thinkl33t/Mendel90/bobhuxley/sheets/y_heatshield.dxf

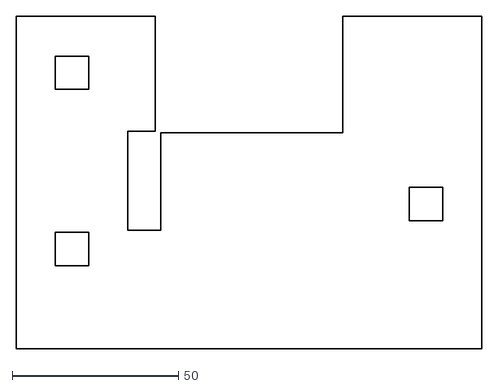
[picture p1: CAD file, 2016-01-12]
bobhuxley/sheets/y_heatshield.dxf
140.0 x 100.0
