thinkl33t/Mendel90/bobhuxley/stls/printed/dust_filter.stl

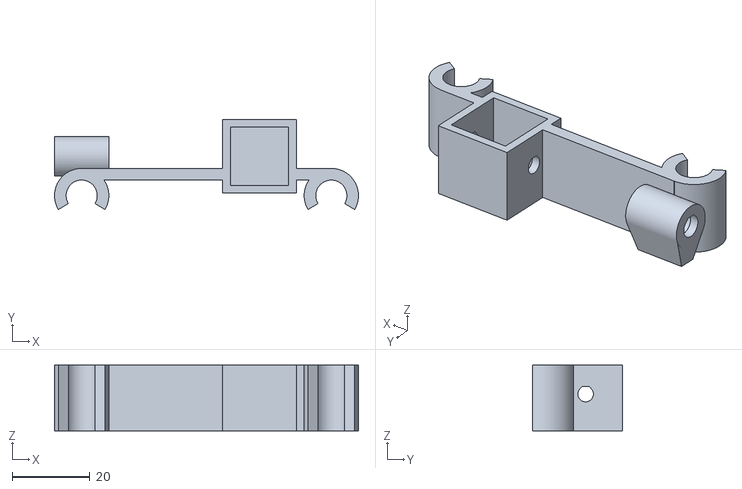
[picture p2: CAD file, 2016-01-12]
bobhuxley/stls/printed/dust_filter.stl
78.3 x 23.2 x 17.0
