thinkl33t/Mendel90/bobhuxley/stls/rpi_camera_back.stl

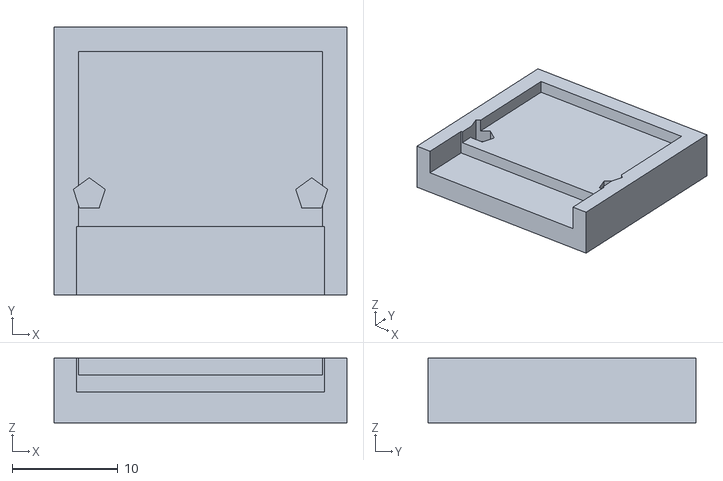
[picture p3: CAD file, 2016-01-12]
bobhuxley/stls/rpi_camera_back.stl
27.7 x 25.3 x 6.10
