thinkl33t/Mendel90/bobhuxley/sheets/frame_left.dxf

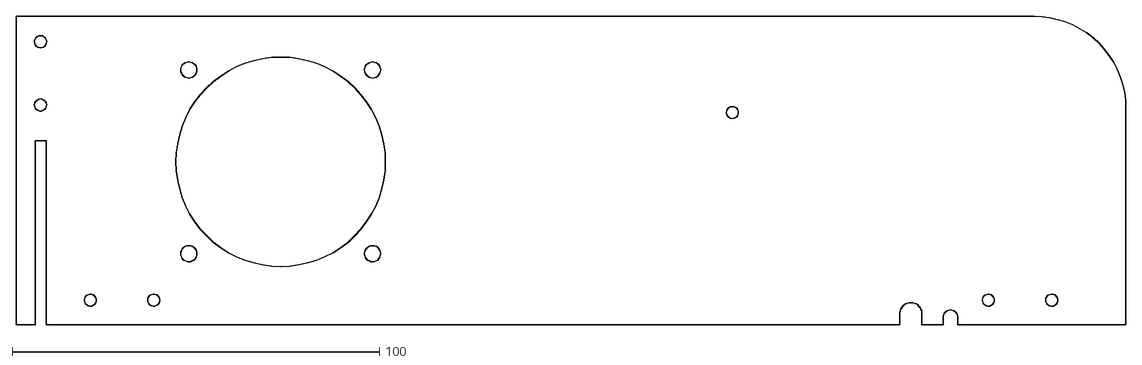
[picture p4: CAD file, 2016-01-12]
bobhuxley/sheets/frame_left.dxf
302.0 x 83.9
