thinkl33t/Mendel90/bobhuxley/stls/printed/tube_cap.stl

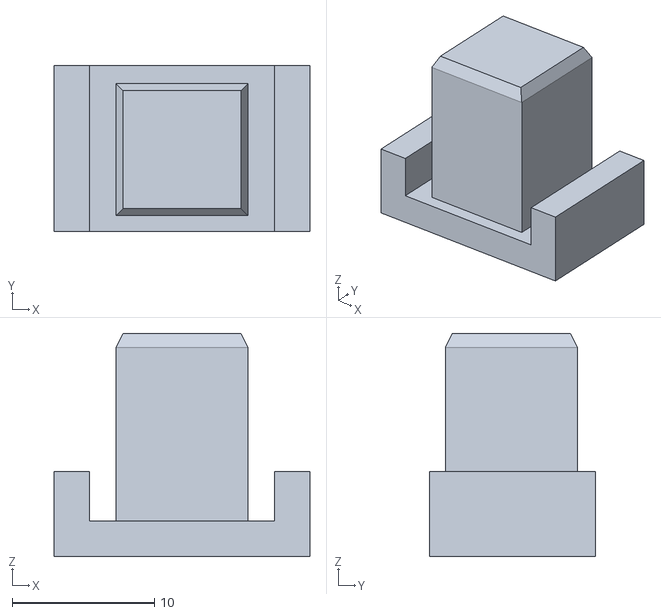
[picture p5: CAD file, 2016-01-12]
bobhuxley/stls/printed/tube_cap.stl
18.0 x 11.7 x 15.7
