thinkl33t/Mendel90/bobhuxley/sheets/frame_gantry_and_y_carriage.dxf

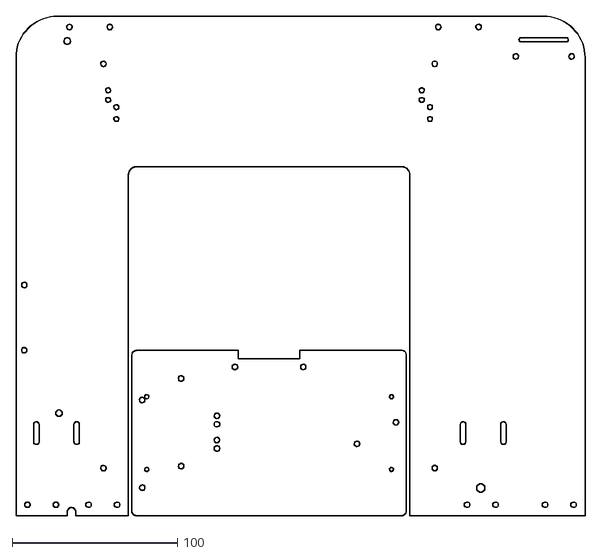
[picture p6: CAD file, 2016-01-12]
bobhuxley/sheets/frame_gantry_and_y_carriage.dxf
344.0 x 302.0
