thinkl33t/Mendel90/bobhuxley/stls/printed/wades_extruder.stl

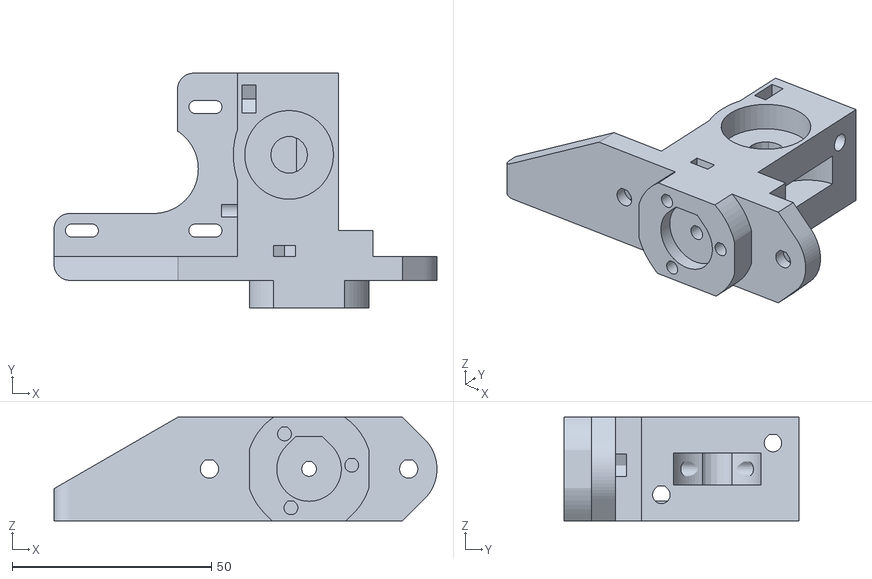
[picture p7: CAD file, 2016-01-12]
bobhuxley/stls/printed/wades_extruder.stl
96.1 x 58.9 x 26.0
