thinkl33t/Mendel90/bobhuxley/stls/y_bar_clamp.stl

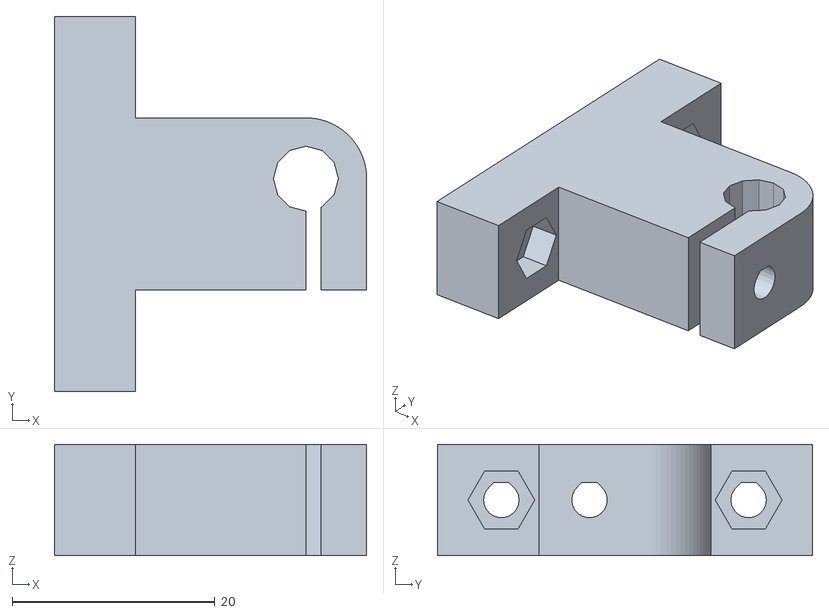
[picture p8: CAD file, 2016-01-12]
bobhuxley/stls/y_bar_clamp.stl
30.8 x 37.0 x 11.0
