thinkl33t/Mendel90/bobhuxley/sheets/frame_base.dxf

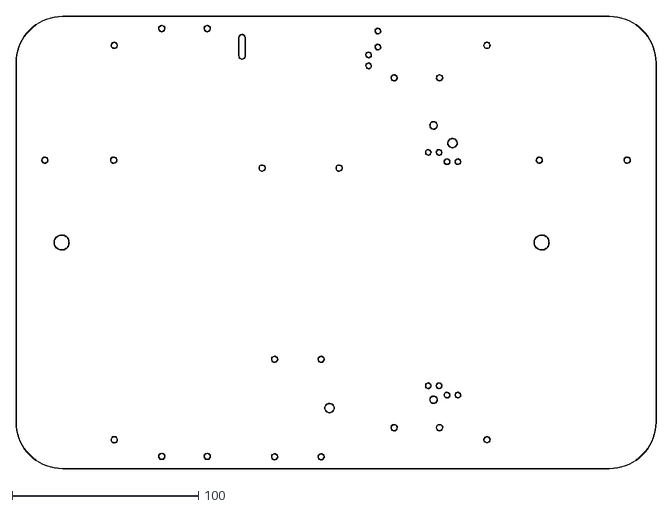
[picture p9: CAD file, 2016-01-12]
bobhuxley/sheets/frame_base.dxf
344.0 x 243.0
