thinkl33t/Mendel90/bobhuxley/stls/printed/y_idler_bracket.stl

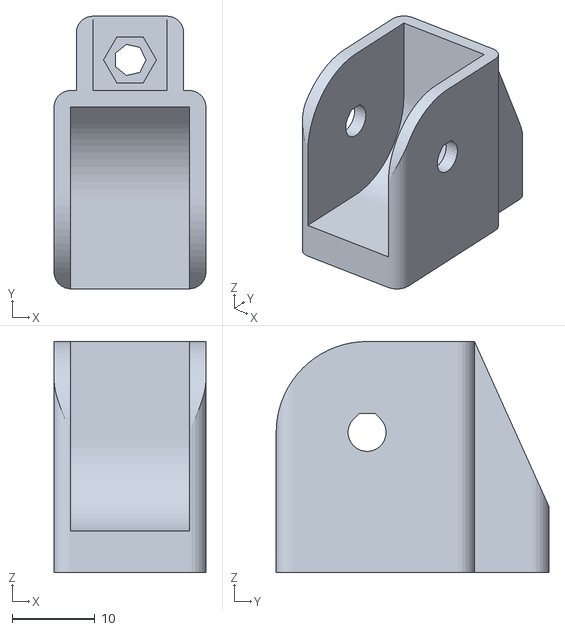
[picture p10: CAD file, 2016-01-12]
bobhuxley/stls/printed/y_idler_bracket.stl
18.4 x 33.0 x 27.9
