thinkl33t/Mendel90/bobhuxley/stls/ribbon_clamp_26_33N.stl

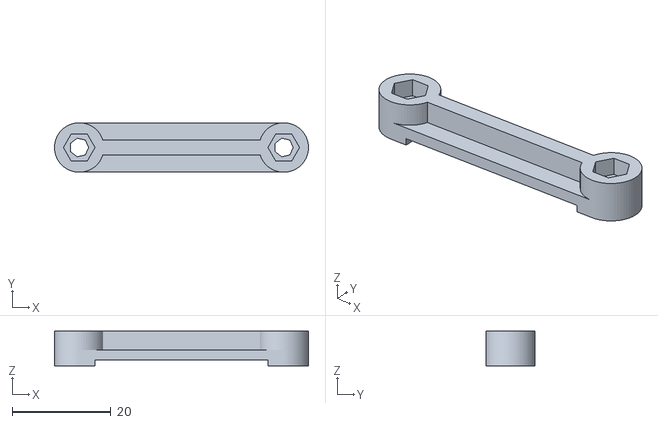
[picture p11: CAD file, 2016-01-12]
bobhuxley/stls/ribbon_clamp_26_33N.stl
51.3 x 10.00 x 7.00
