thinkl33t/Mendel90/bobhuxley/sheets/frame_stays.dxf

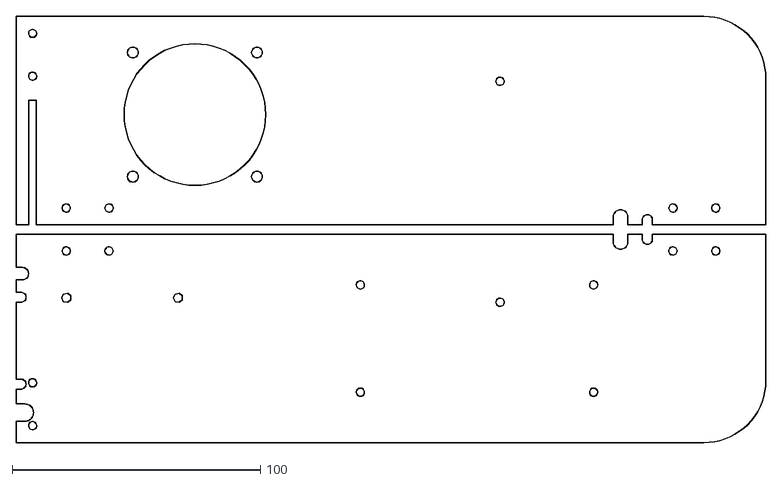
[picture p12: CAD file, 2016-01-12]
bobhuxley/sheets/frame_stays.dxf
302.0 x 171.8
