thinkl33t/Mendel90/bobhuxley/stls/ribbon_clamp_14_33NB.stl

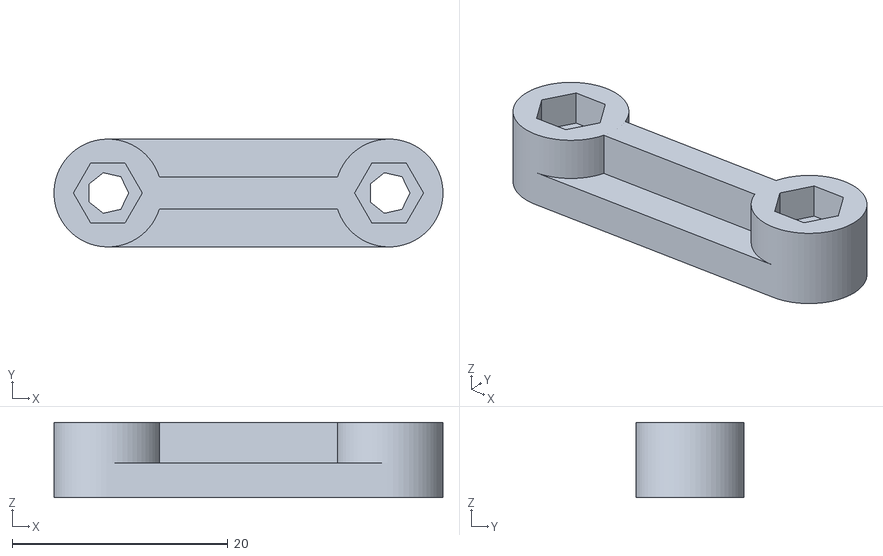
[picture p13: CAD file, 2016-01-12]
bobhuxley/stls/ribbon_clamp_14_33NB.stl
36.1 x 10.00 x 7.00
