thinkl33t/Mendel90/bobhuxley/sheets/frame_right.dxf

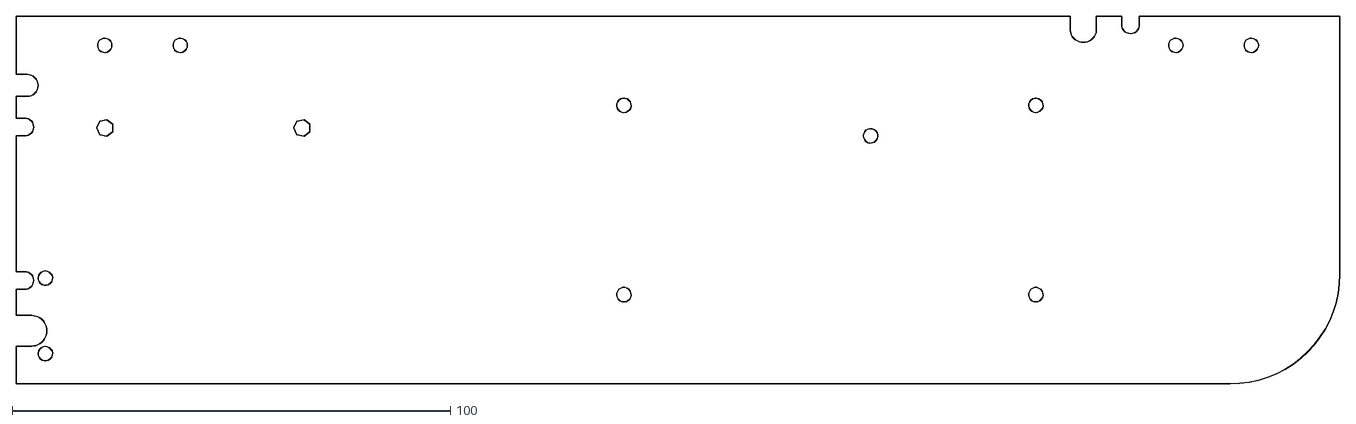
[picture p14: CAD file, 2016-01-12]
bobhuxley/sheets/frame_right.dxf
302.0 x 83.9
