thinkl33t/Mendel90/bobhuxley/stls/printed/spool_holder_brackets.stl

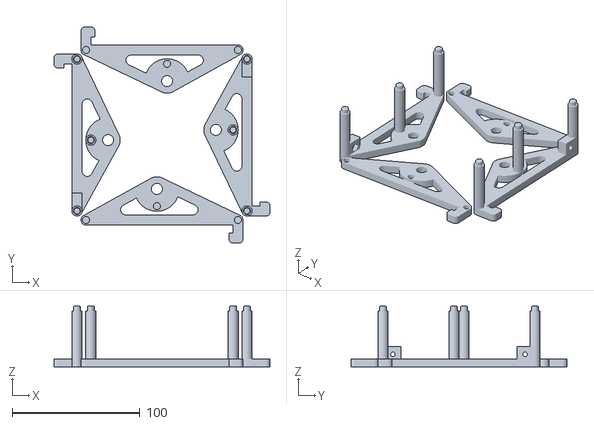
[picture p15: CAD file, 2016-01-12]
bobhuxley/stls/printed/spool_holder_brackets.stl
168.9 x 168.9 x 47.4
