thinkl33t/Mendel90/bobhuxley/stls/y_belt_anchor_toothed.stl

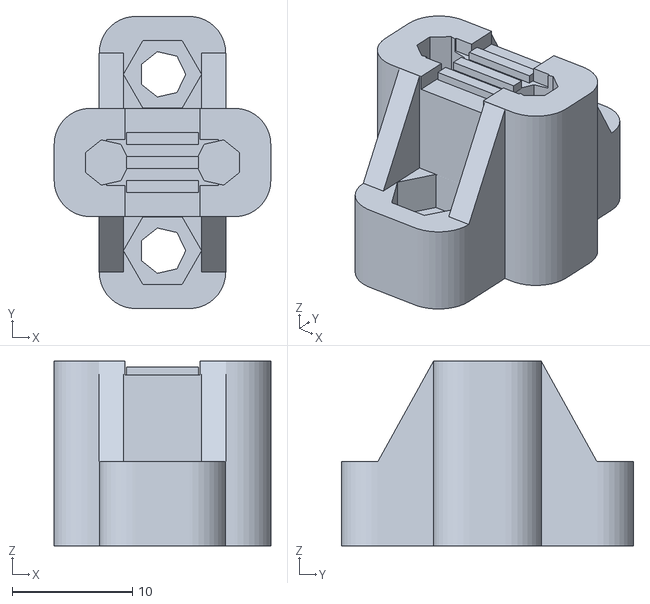
[picture p16: CAD file, 2016-01-12]
bobhuxley/stls/y_belt_anchor_toothed.stl
18.0 x 24.3 x 15.3
