thinkl33t/Mendel90/bobhuxley/sheets/frame_gantry.dxf

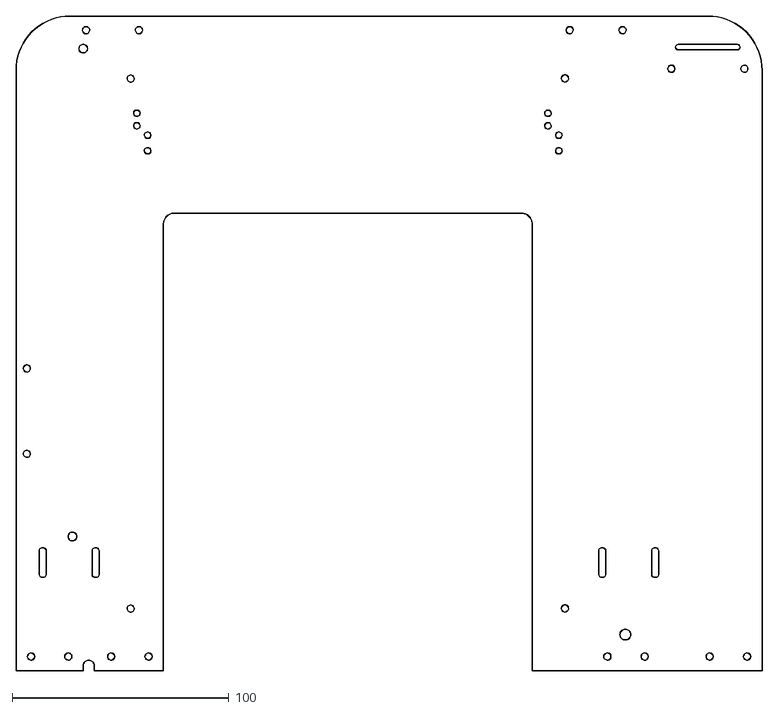
[picture p17: CAD file, 2016-01-12]
bobhuxley/sheets/frame_gantry.dxf
344.0 x 302.0
