thinkl33t/Mendel90/bobhuxley/stls/printed/fixing_blocks.stl

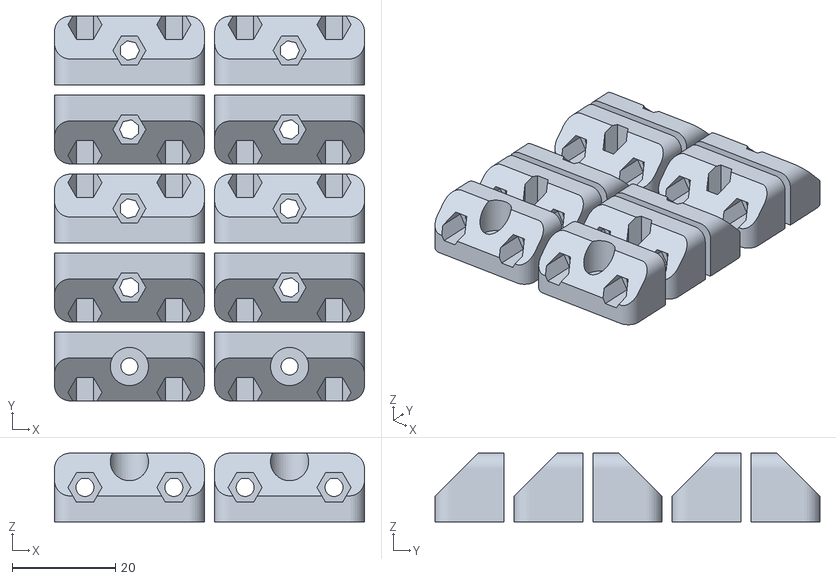
[picture p18: CAD file, 2016-01-12]
bobhuxley/stls/printed/fixing_blocks.stl
60.0 x 74.5 x 13.3
