thinkl33t/Mendel90/bobhuxley/stls/x_belt_tensioner.stl

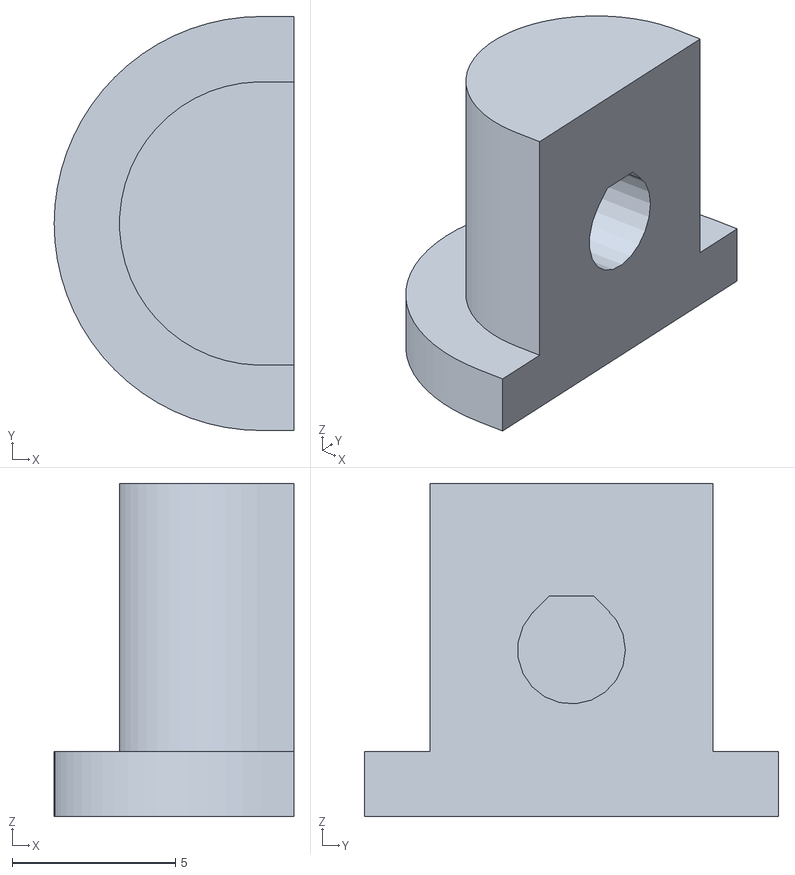
[picture p19: CAD file, 2016-01-12]
bobhuxley/stls/x_belt_tensioner.stl
7.33 x 12.7 x 10.2
