thinkl33t/Mendel90/bobhuxley/sheets/y_carriage.dxf

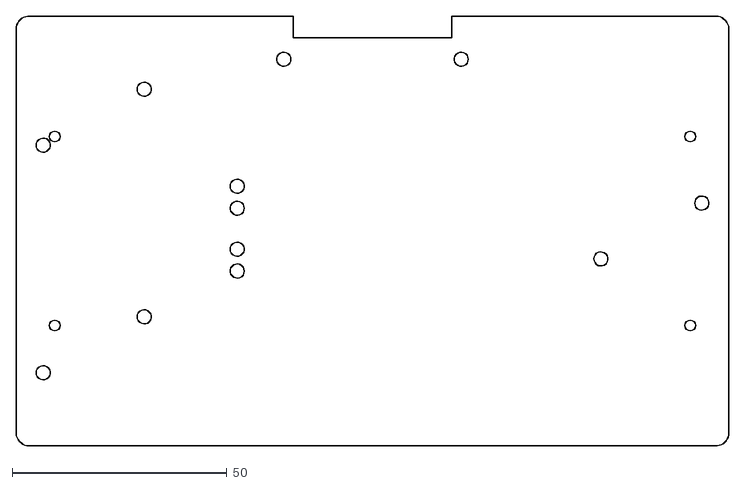
[picture p20: CAD file, 2016-01-12]
bobhuxley/sheets/y_carriage.dxf
166.0 x 100.0
