thinkl33t/Mendel90/bobhuxley/stls/printed/cable_clips.stl

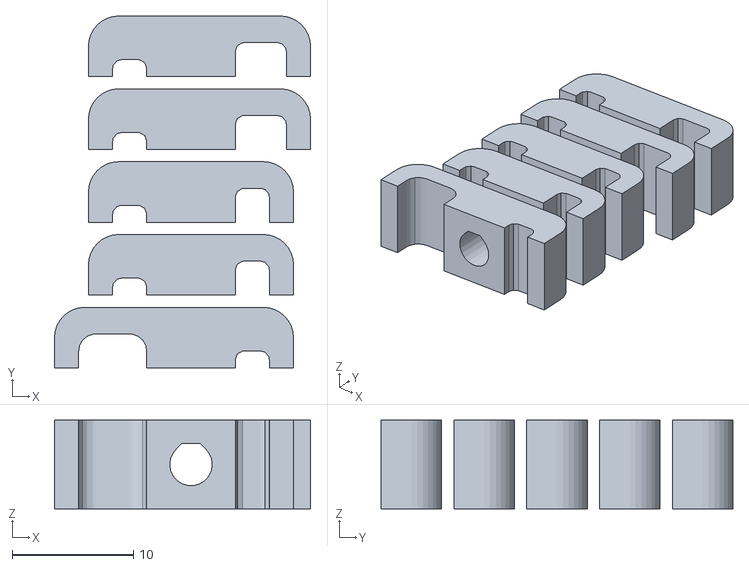
[picture p21: CAD file, 2016-01-12]
bobhuxley/stls/printed/cable_clips.stl
21.1 x 29.0 x 7.30
