thinkl33t/Mendel90/bobhuxley/stls/z_bar_clamp.stl

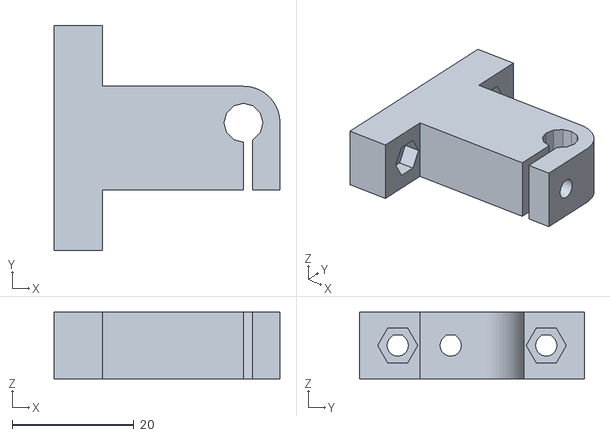
[picture p22: CAD file, 2016-01-12]
bobhuxley/stls/z_bar_clamp.stl
37.1 x 37.0 x 11.0
