thinkl33t/Mendel90/bobhuxley/stls/printed/z_coupling.stl

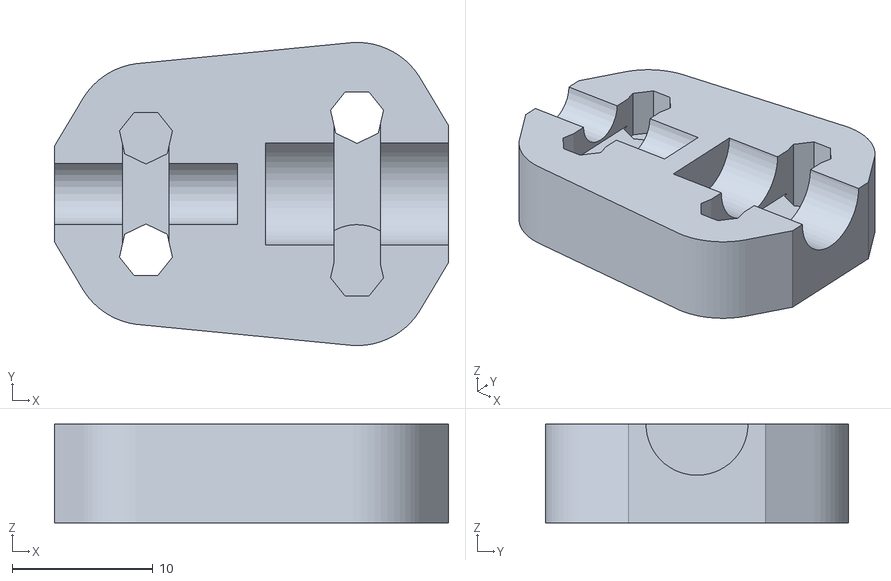
[picture p23: CAD file, 2016-01-12]
bobhuxley/stls/printed/z_coupling.stl
28.0 x 21.5 x 7.00
