thinkl33t/Mendel90/bobhuxley/stls/ribbon_clamp_14_33.stl

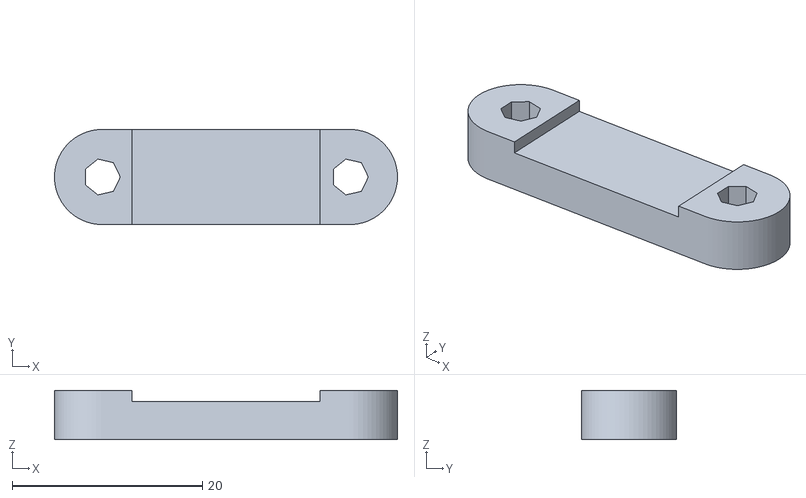
[picture p24: CAD file, 2016-01-12]
bobhuxley/stls/ribbon_clamp_14_33.stl
36.1 x 10.00 x 5.20
