thinkl33t/Mendel90/bobhuxley/stls/printed/x_idler_bracket.stl

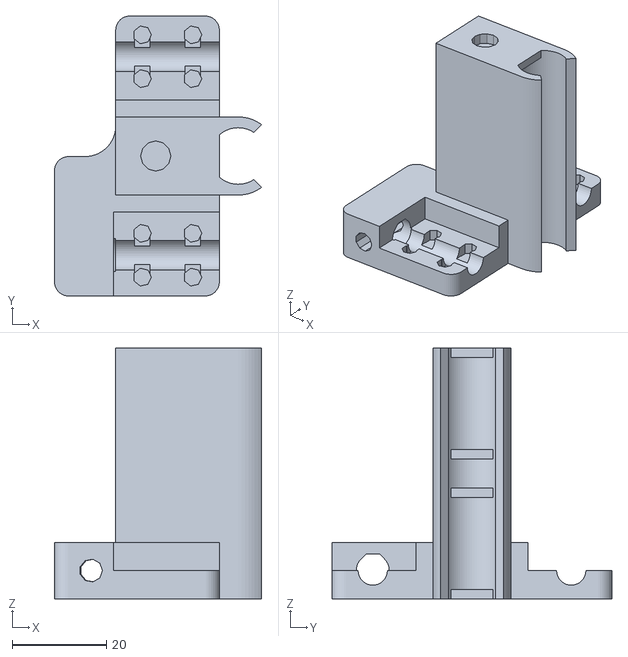
[picture p25: CAD file, 2016-01-12]
bobhuxley/stls/printed/x_idler_bracket.stl
43.9 x 59.4 x 53.2
