thinkl33t/Mendel90/bobhuxley/stls/x_carriage_fan_bracket.stl

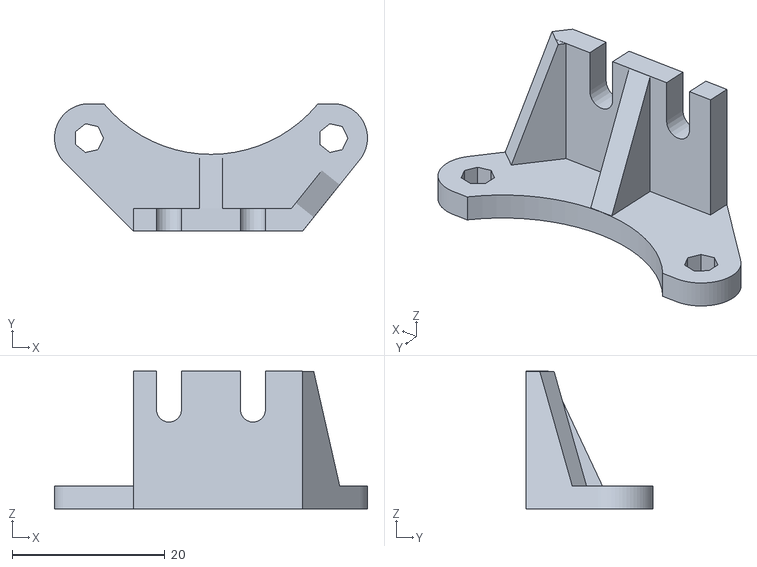
[picture p26: CAD file, 2016-01-12]
bobhuxley/stls/x_carriage_fan_bracket.stl
41.0 x 16.7 x 18.0
