thinkl33t/Mendel90/bobhuxley/stls/d_motor_bracket_lid.stl

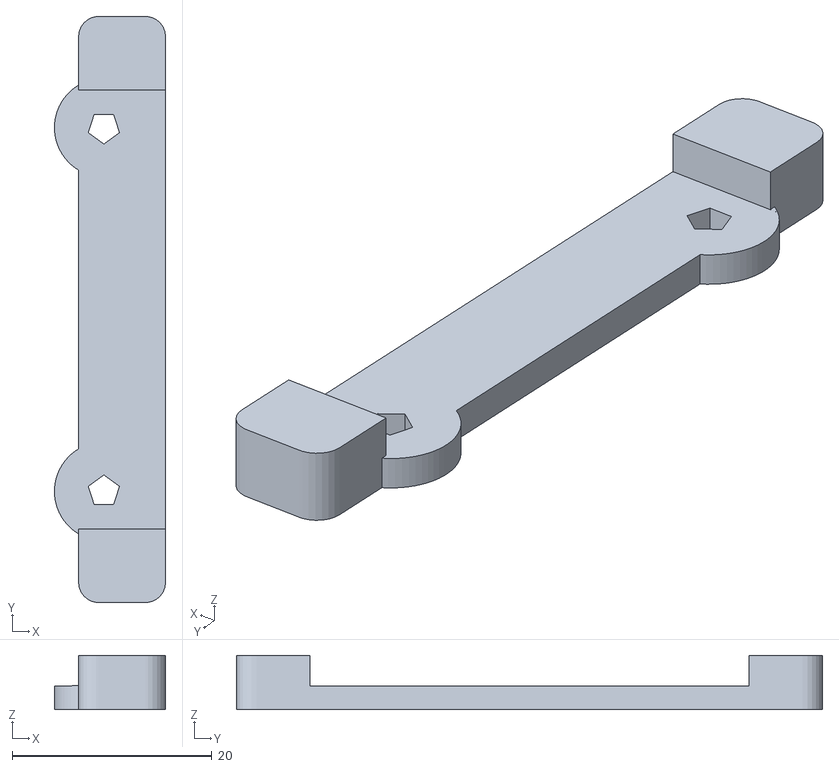
[picture p27: CAD file, 2016-01-12]
bobhuxley/stls/d_motor_bracket_lid.stl
11.1 x 58.6 x 5.45
