thinkl33t/Mendel90/bobhuxley/stls/printed/x_motor_bracket.stl

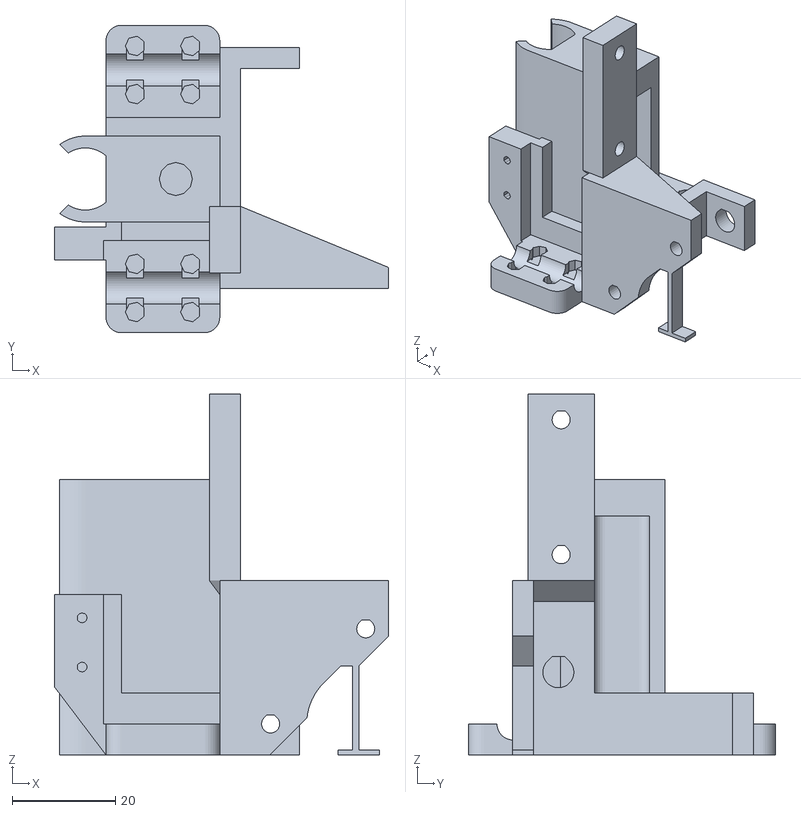
[picture p28: CAD file, 2016-01-12]
bobhuxley/stls/printed/x_motor_bracket.stl
64.6 x 59.4 x 69.8
