thinkl33t/Mendel90/bobhuxley/stls/printed/z_motor_brackets.stl

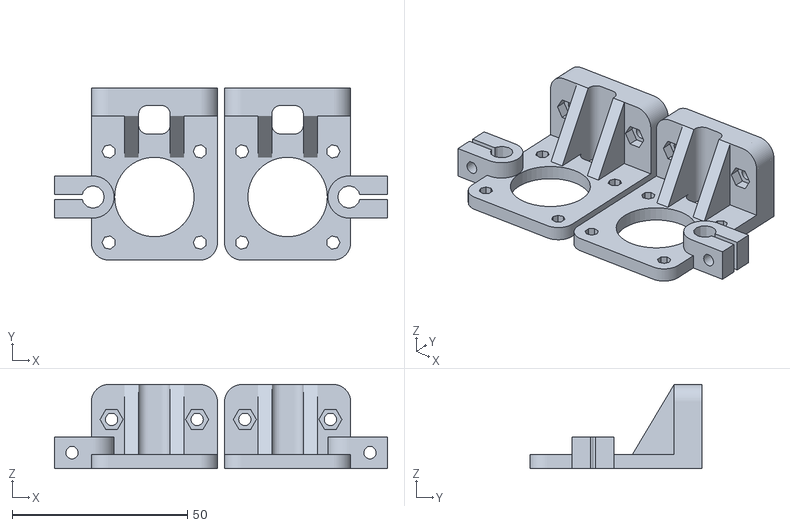
[picture p29: CAD file, 2016-01-12]
bobhuxley/stls/printed/z_motor_brackets.stl
95.0 x 49.1 x 24.0
