thinkl33t/Mendel90/bobhuxley/stls/spool_bracket_male.stl

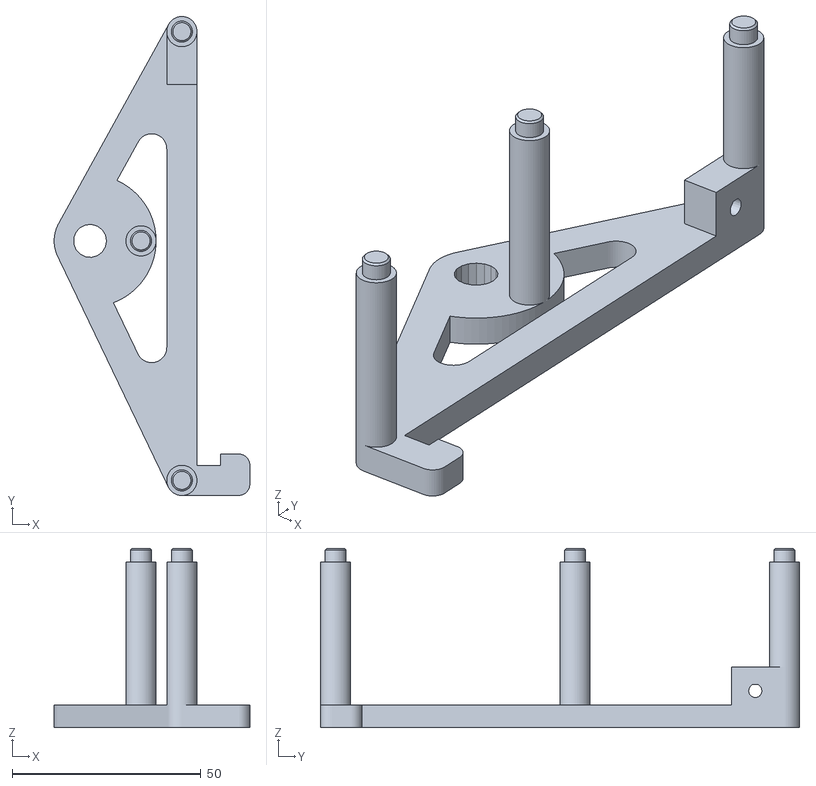
[picture p30: CAD file, 2016-01-12]
bobhuxley/stls/spool_bracket_male.stl
51.8 x 126.8 x 47.4
