thinkl33t/Mendel90/bobhuxley/stls/printed/y_motor_bracket.stl

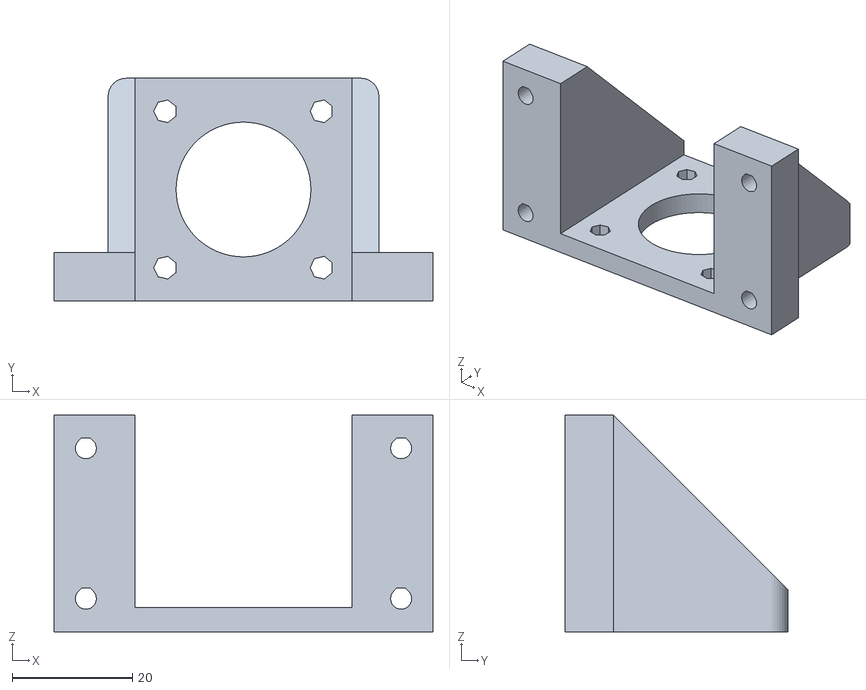
[picture p31: CAD file, 2016-01-12]
bobhuxley/stls/printed/y_motor_bracket.stl
63.0 x 37.0 x 36.0
