thinkl33t/Mendel90/bobhuxley/stls/z_motor_bracket_rhs.stl

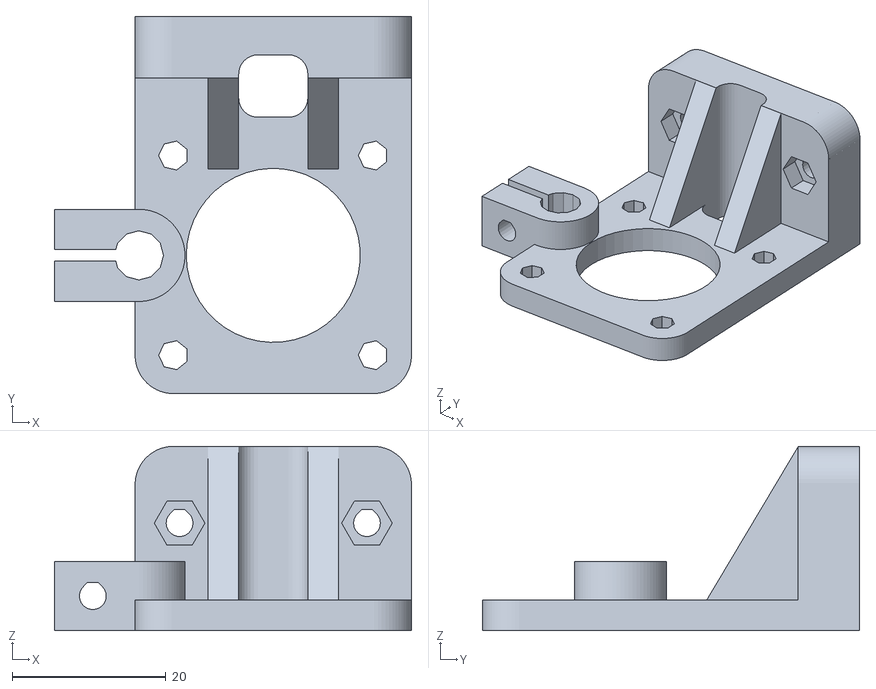
[picture p32: CAD file, 2016-01-12]
bobhuxley/stls/z_motor_bracket_rhs.stl
46.5 x 49.1 x 24.0
