thinkl33t/Mendel90/bobhuxley/stls/printed/x_end_clamp.stl

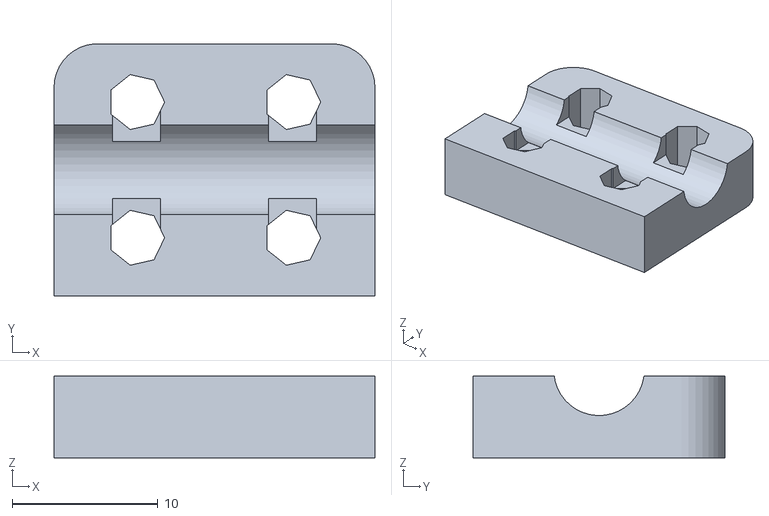
[picture p33: CAD file, 2016-01-12]
bobhuxley/stls/printed/x_end_clamp.stl
22.0 x 17.3 x 5.60
