thinkl33t/Mendel90/bobhuxley/stls/printed/atx_brackets.stl

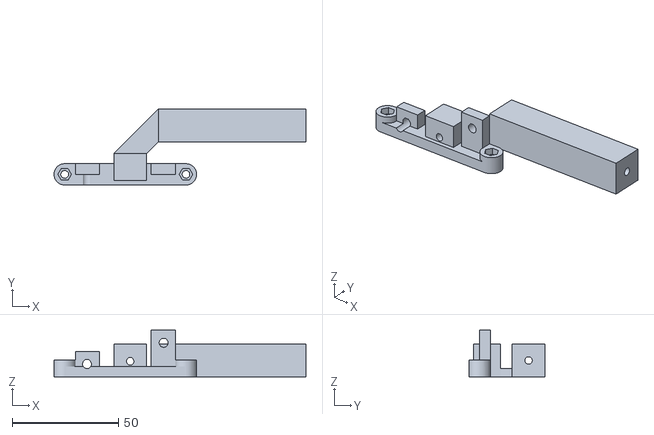
[picture p34: CAD file, 2016-01-12]
bobhuxley/stls/printed/atx_brackets.stl
118.4 x 35.7 x 22.0
