thinkl33t/Mendel90/bobhuxley/stls/x_carriage.stl

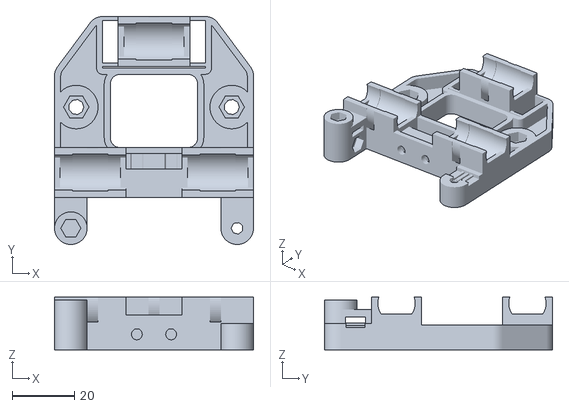
[picture p35: CAD file, 2016-01-12]
bobhuxley/stls/x_carriage.stl
64.0 x 73.3 x 17.0
