thinkl33t/Mendel90/bobhuxley/stls/printed/cal.stl

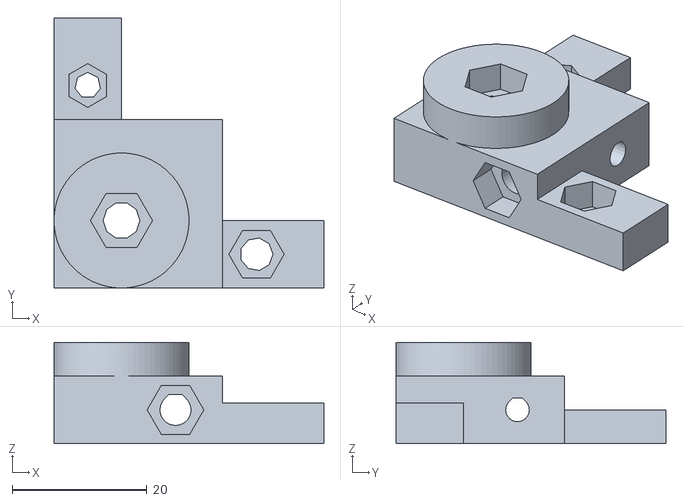
[picture p36: CAD file, 2016-01-12]
bobhuxley/stls/printed/cal.stl
40.0 x 40.0 x 15.0
