thinkl33t/Mendel90/bobhuxley/stls/direct_block.stl

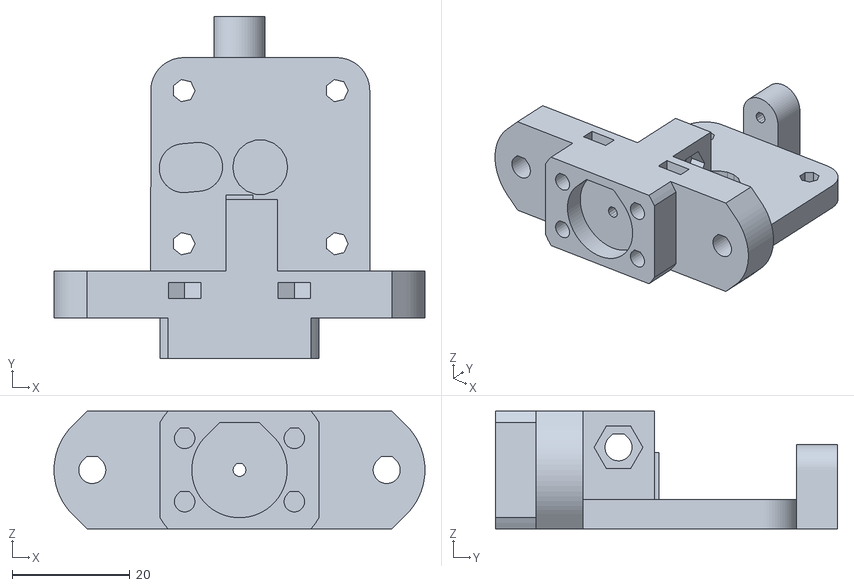
[picture p37: CAD file, 2016-01-12]
bobhuxley/stls/direct_block.stl
63.0 x 58.1 x 20.0
