thinkl33t/Mendel90/bobhuxley/stls/printed/direct_idler_lever.stl

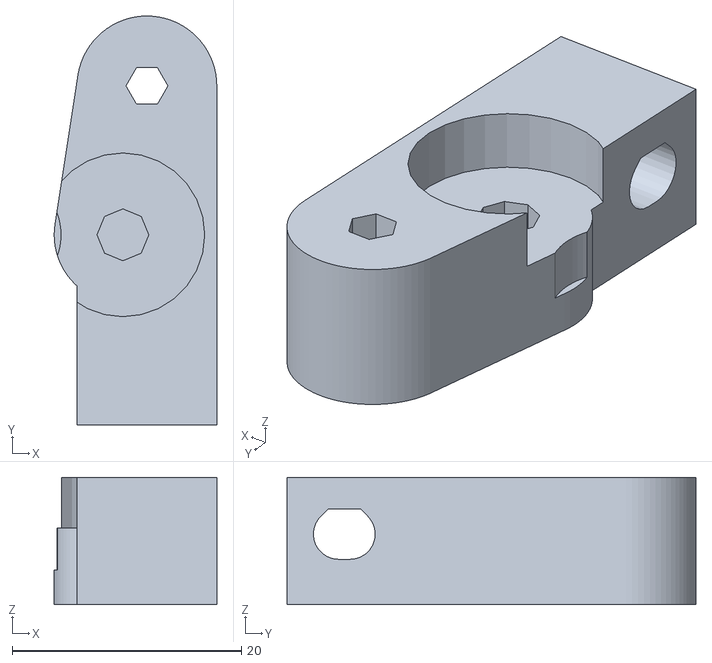
[picture p38: CAD file, 2016-01-12]
bobhuxley/stls/printed/direct_idler_lever.stl
14.2 x 35.7 x 11.1
