thinkl33t/Mendel90/bobhuxley/stls/printed/light_and_camera_brackets.stl

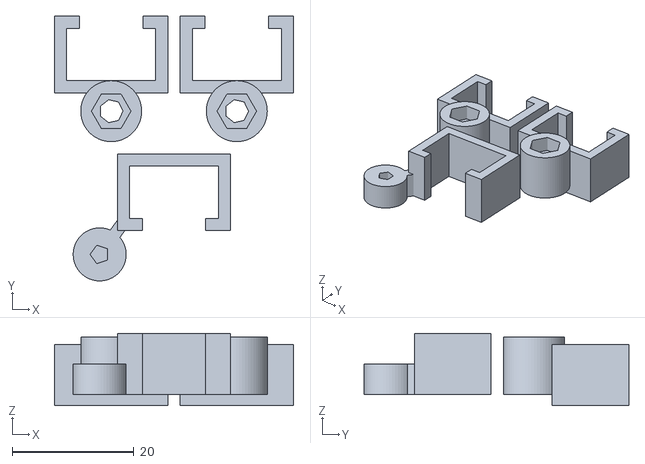
[picture p39: CAD file, 2016-01-12]
bobhuxley/stls/printed/light_and_camera_brackets.stl
39.2 x 43.4 x 11.8
