thinkl33t/Mendel90/bobhuxley/stls/printed/y_belt_anchors.stl

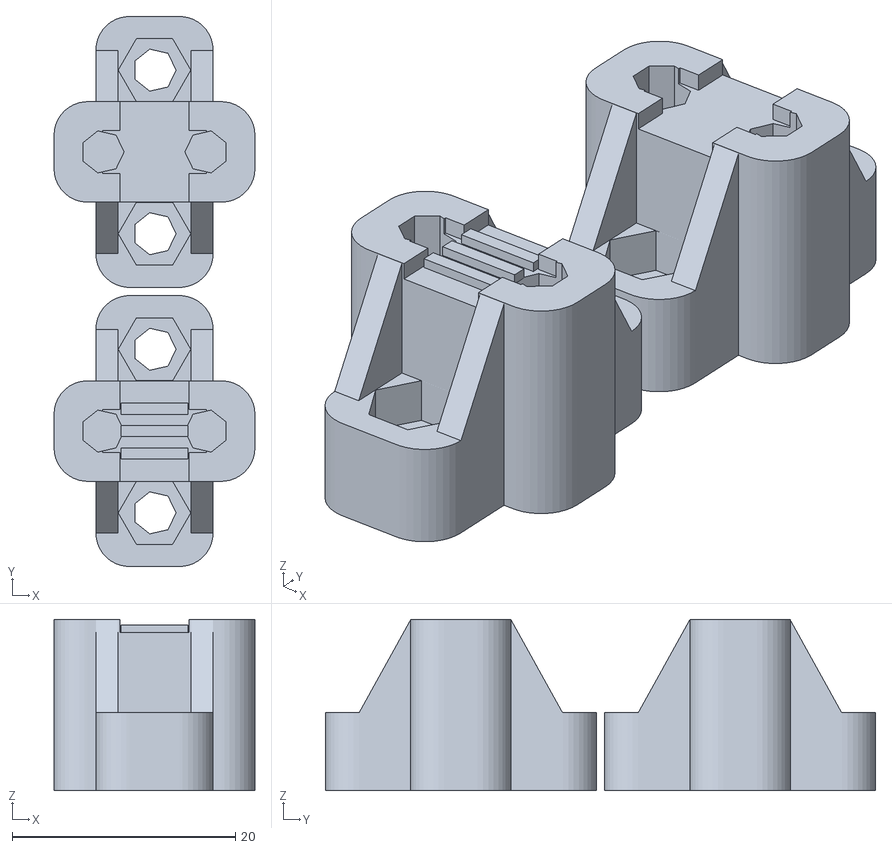
[picture p40: CAD file, 2016-01-12]
bobhuxley/stls/printed/y_belt_anchors.stl
18.0 x 49.3 x 15.3
