thinkl33t/Mendel90/bobhuxley/stls/printed/bar_clamps.stl

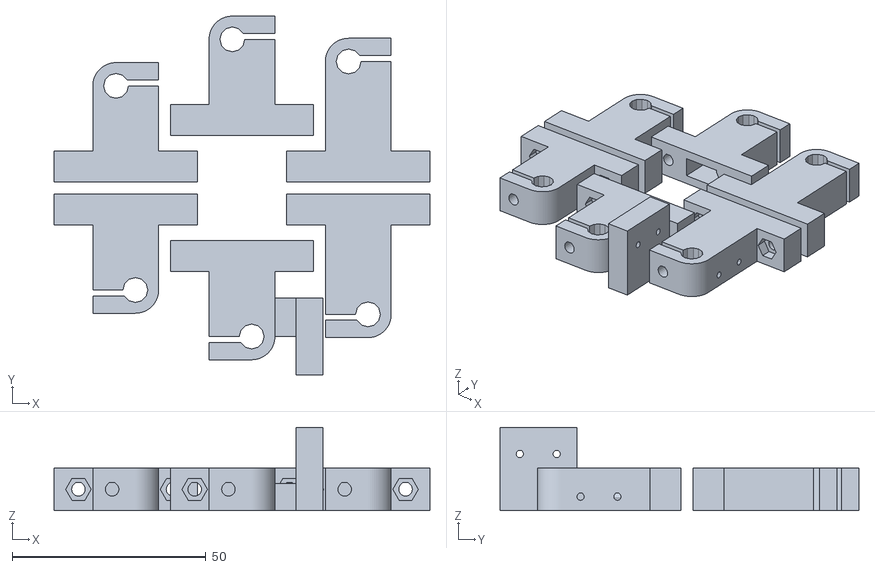
[picture p41: CAD file, 2016-01-12]
bobhuxley/stls/printed/bar_clamps.stl
97.0 x 92.6 x 21.5
