thinkl33t/Mendel90/bobhuxley/stls/d_shell_lid.stl

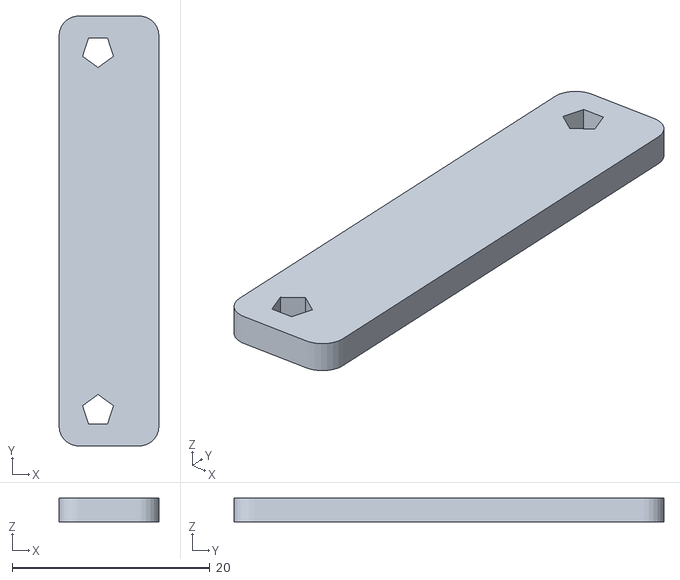
[picture p43: CAD file, 2016-01-12]
bobhuxley/stls/d_shell_lid.stl
10.1 x 43.5 x 2.40
