thinkl33t/Mendel90/bobhuxley/stls/printed/y_bearing_mounts.stl

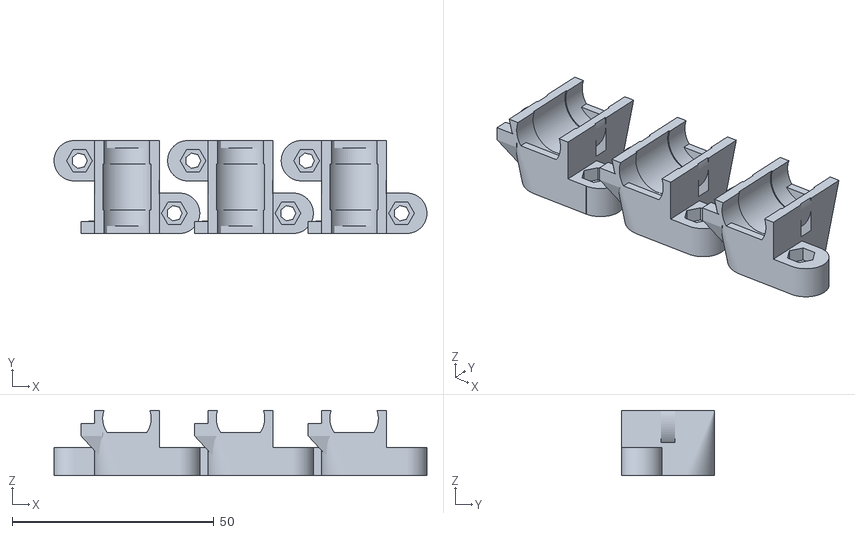
[picture p44: CAD file, 2016-01-12]
bobhuxley/stls/printed/y_bearing_mounts.stl
92.3 x 23.0 x 16.2
