thinkl33t/Mendel90/bobhuxley/stls/printed/small_bits.stl

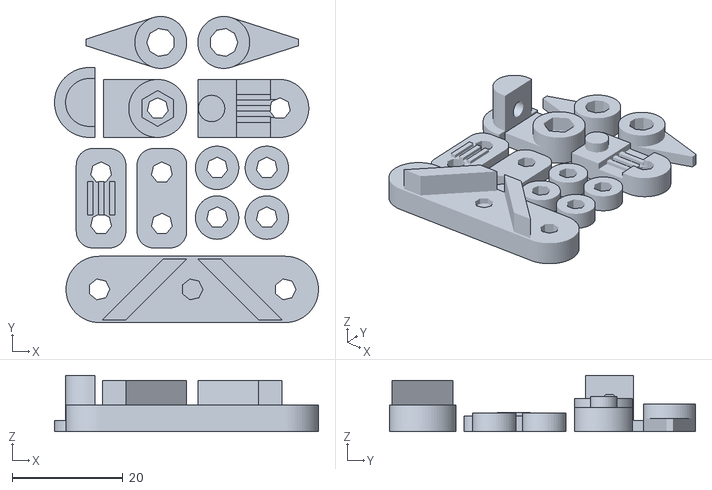
[picture p45: CAD file, 2016-01-12]
bobhuxley/stls/printed/small_bits.stl
47.8 x 55.4 x 10.2
