thinkl33t/Mendel90/bobhuxley/stls/fixing_block.stl

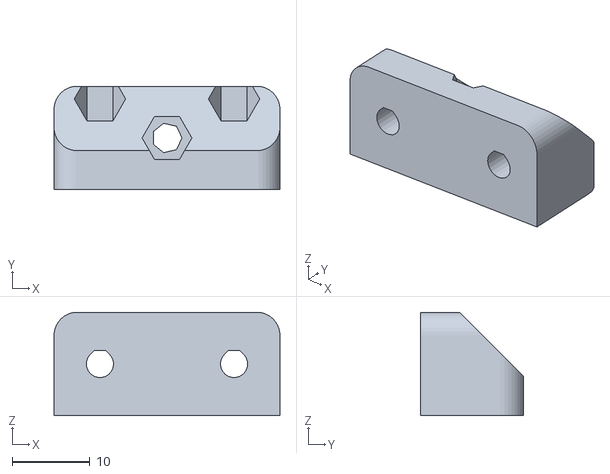
[picture p46: CAD file, 2016-01-12]
bobhuxley/stls/fixing_block.stl
29.0 x 13.3 x 13.3
