thinkl33t/Mendel90/bobhuxley/stls/printed/x_carriage_parts.stl

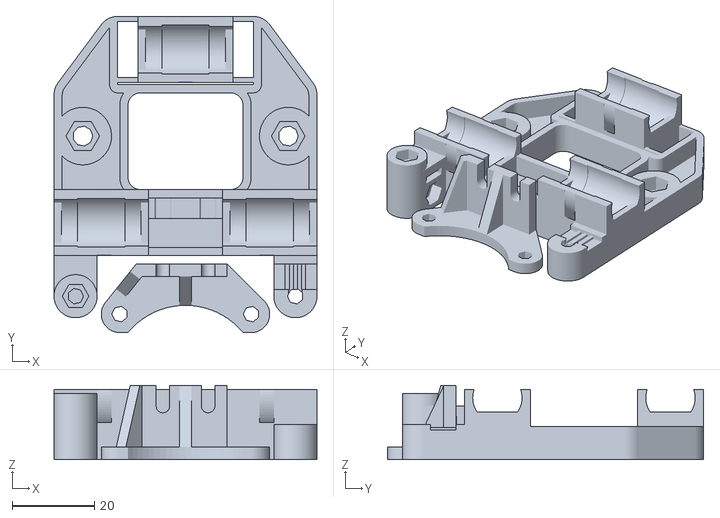
[picture p47: CAD file, 2016-01-12]
bobhuxley/stls/printed/x_carriage_parts.stl
64.0 x 76.9 x 18.0
