thinkl33t/Mendel90/bobhuxley/stls/printed/ribbon_clamps.stl

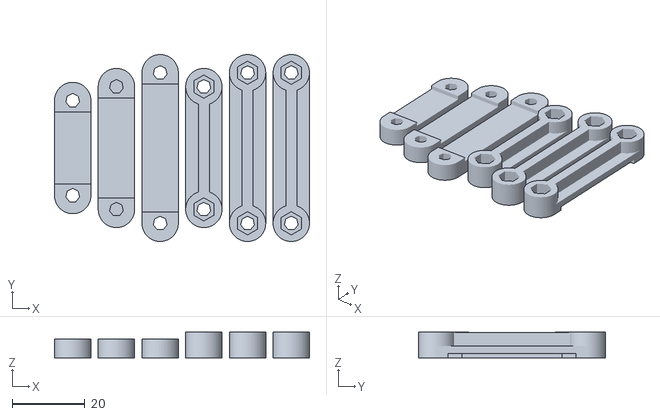
[picture p48: CAD file, 2016-01-12]
bobhuxley/stls/printed/ribbon_clamps.stl
70.0 x 51.3 x 7.00
