thinkl33t/Mendel90/bobhuxley/stls/printed/x_carriage_fan_duct.stl

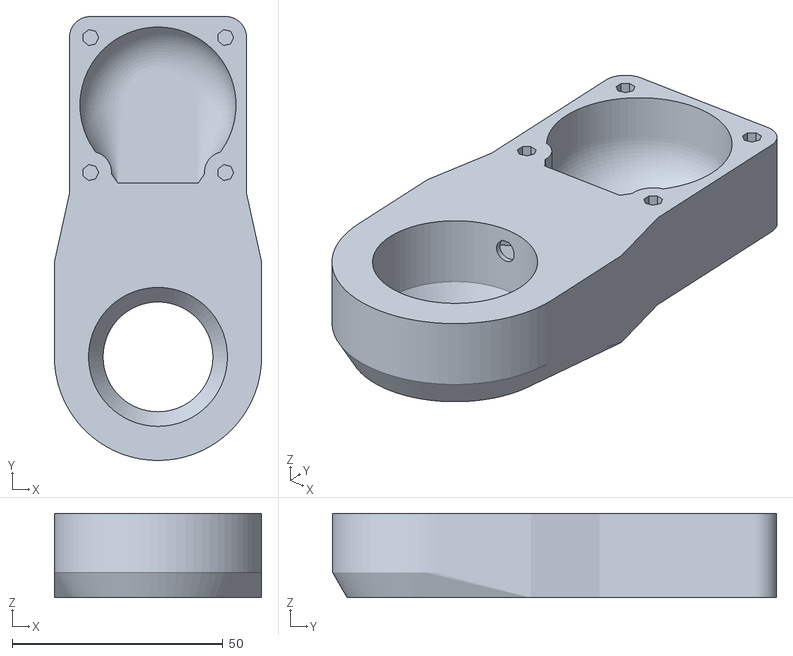
[picture p49: CAD file, 2016-01-12]
bobhuxley/stls/printed/x_carriage_fan_duct.stl
49.1 x 105.3 x 20.0
