thinkl33t/Mendel90/bobhuxley/stls/ribbon_clamp_26_33.stl

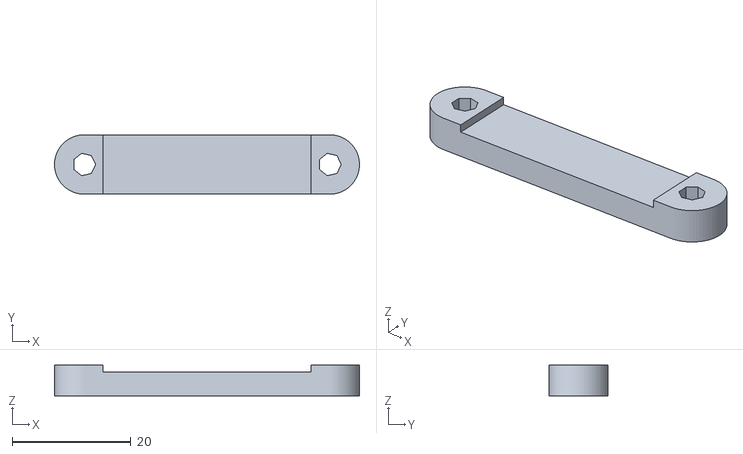
[picture p50: CAD file, 2016-01-12]
bobhuxley/stls/ribbon_clamp_26_33.stl
51.3 x 10.00 x 5.20
