thinkl33t/Mendel90/bobhuxley/stls/printed/fan_guard.stl

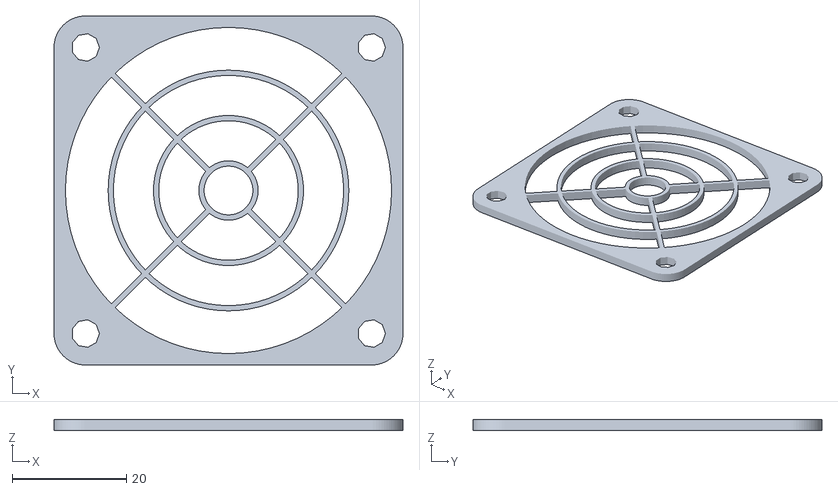
[picture p51: CAD file, 2016-01-12]
bobhuxley/stls/printed/fan_guard.stl
61.0 x 61.0 x 2.00
