thinkl33t/Mendel90/bobhuxley/stls/printed/rear_light_brackets.stl

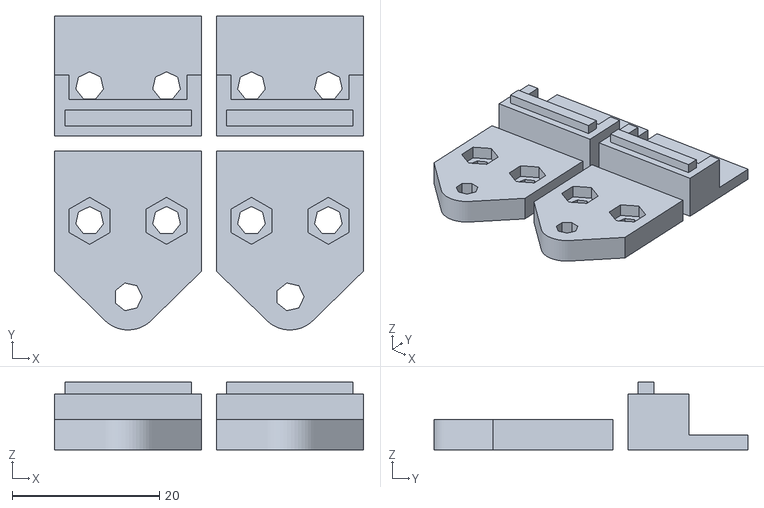
[picture p52: CAD file, 2016-01-12]
bobhuxley/stls/printed/rear_light_brackets.stl
42.0 x 42.7 x 9.20
