thinkl33t/Mendel90/bobhuxley/stls/y_belt_clip_toothed.stl

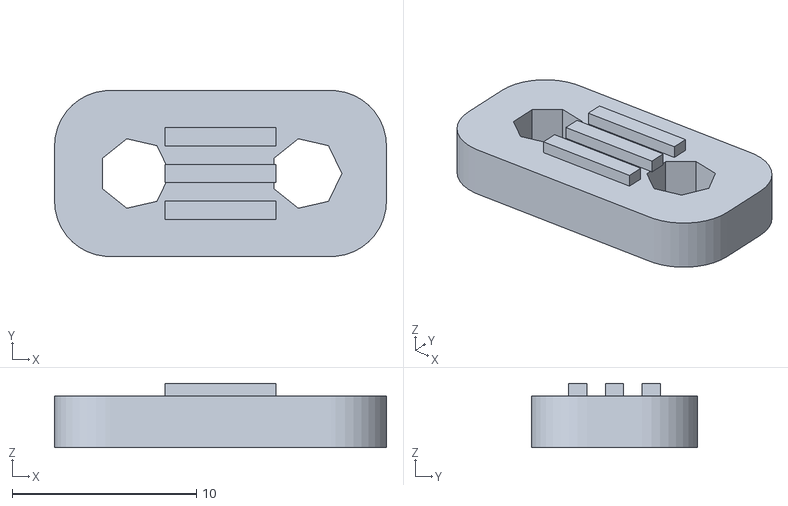
[picture p53: CAD file, 2016-01-12]
bobhuxley/stls/y_belt_clip_toothed.stl
18.0 x 9.00 x 3.48
