thinkl33t/Mendel90/bobhuxley/stls/printed/d_motor_brackets.stl

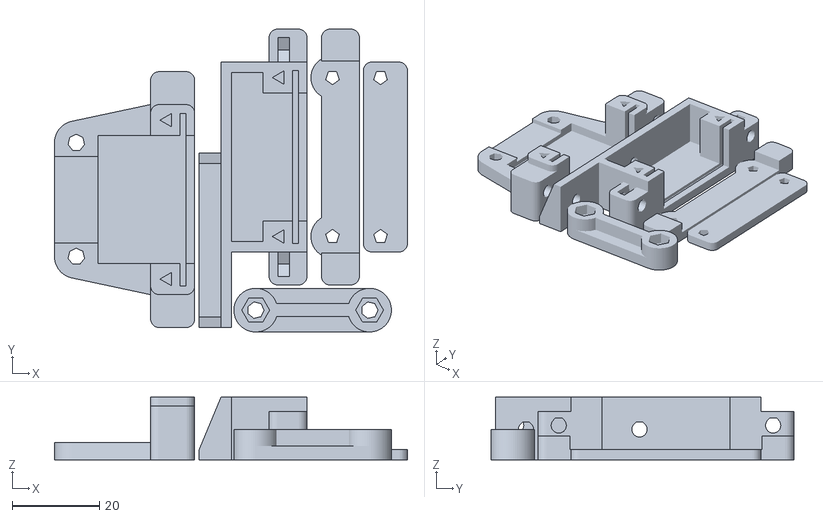
[picture p54: CAD file, 2016-01-12]
bobhuxley/stls/printed/d_motor_brackets.stl
80.8 x 69.4 x 14.4
