thinkl33t/Mendel90/bobhuxley/stls/printed/rpi_camera_case.stl

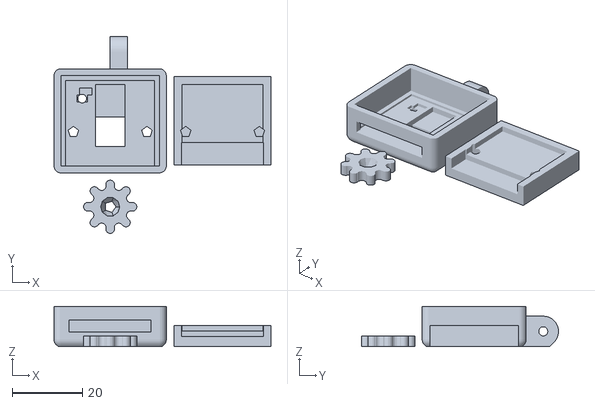
[picture p55: CAD file, 2016-01-12]
bobhuxley/stls/printed/rpi_camera_case.stl
61.9 x 56.2 x 11.5
