thinkl33t/Mendel90/bobhuxley/stls/x_belt_grip.stl

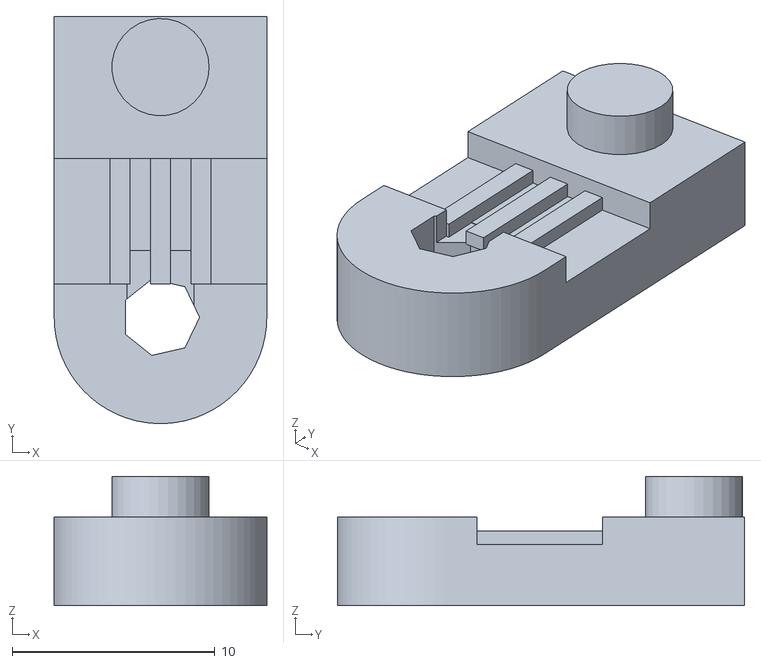
[picture p56: CAD file, 2016-01-12]
bobhuxley/stls/x_belt_grip.stl
10.5 x 20.1 x 6.39
