thinkl33t/Mendel90/bobhuxley/stls/d_motor_bracket.stl

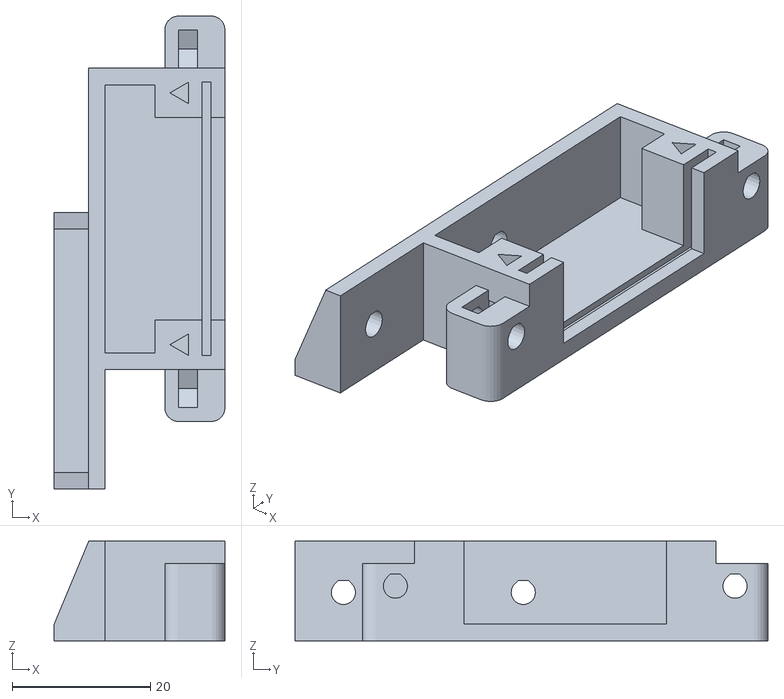
[picture p57: CAD file, 2016-01-12]
bobhuxley/stls/d_motor_bracket.stl
24.7 x 68.4 x 14.4
