thinkl33t/Mendel90/bobhuxley/stls/x_motor_ribbon_bracket.stl

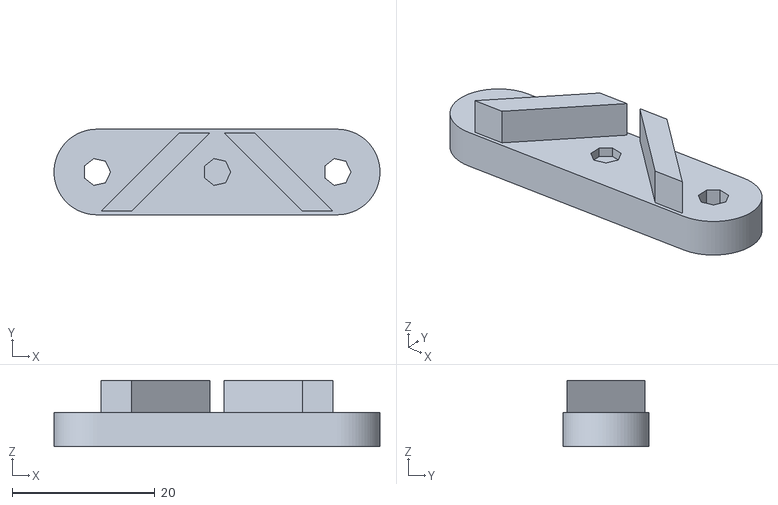
[picture p58: CAD file, 2016-01-12]
bobhuxley/stls/x_motor_ribbon_bracket.stl
45.7 x 12.0 x 9.30
