thinkl33t/Mendel90/bobhuxley/stls/y_bearing_mount.stl

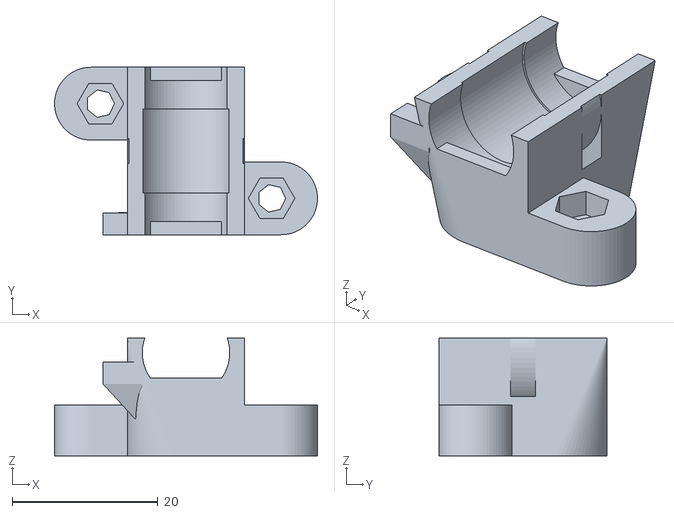
[picture p59: CAD file, 2016-01-12]
bobhuxley/stls/y_bearing_mount.stl
36.1 x 23.0 x 16.2
