thinkl33t/Mendel90/bobhuxley/stls/spool_bracket_female.stl

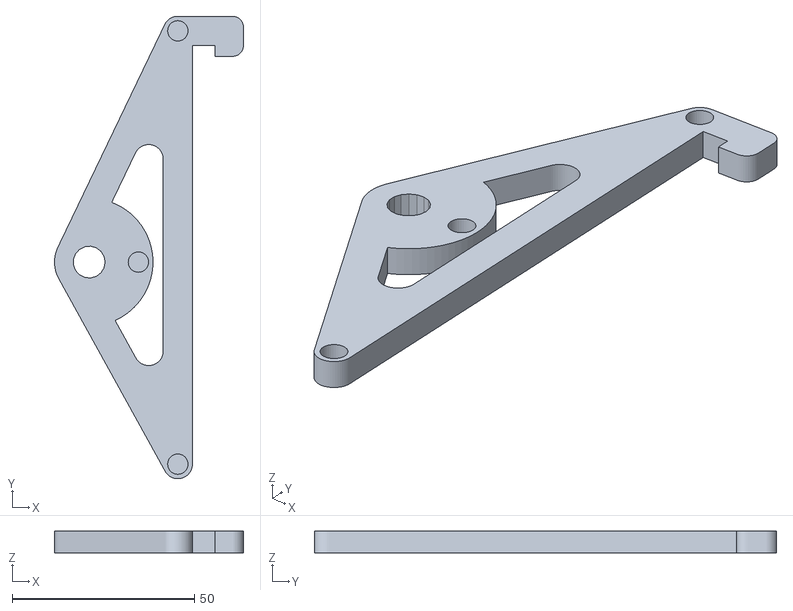
[picture p60: CAD file, 2016-01-12]
bobhuxley/stls/spool_bracket_female.stl
51.8 x 126.8 x 6.00
