thinkl33t/Mendel90/bobhuxley/stls/ribbon_clamp_20_33N.stl

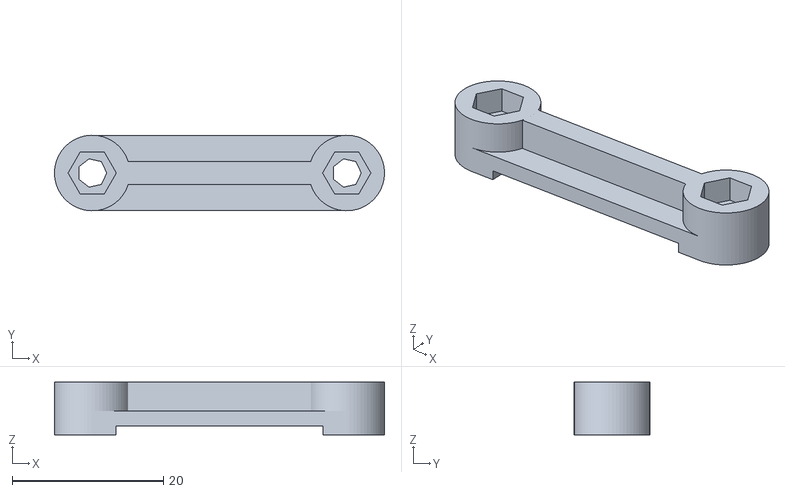
[picture p61: CAD file, 2016-01-12]
bobhuxley/stls/ribbon_clamp_20_33N.stl
43.7 x 10.00 x 7.00
