thinkl33t/Mendel90/bobhuxley/stls/pcb_spacer.stl

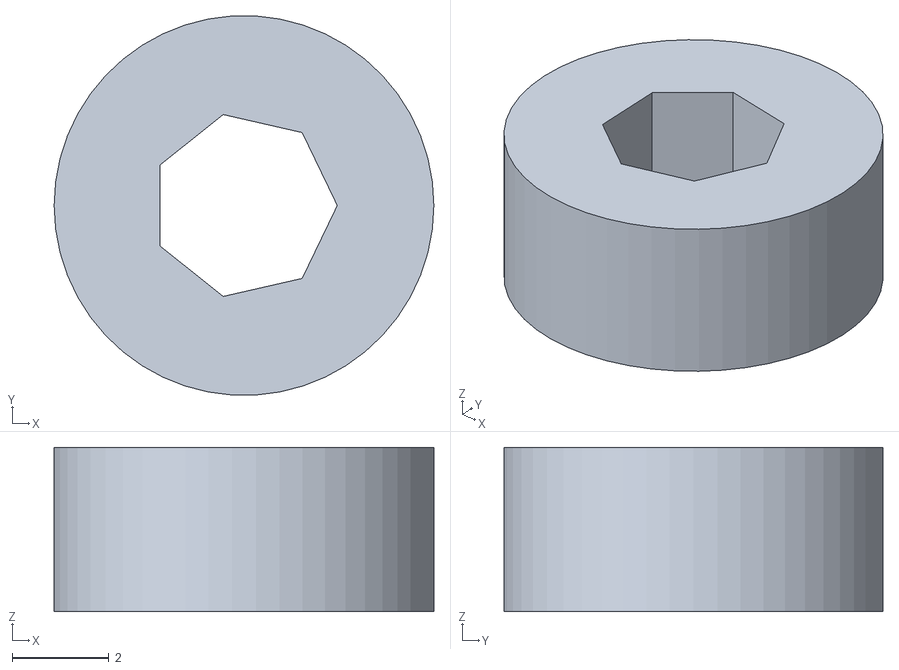
[picture p62: CAD file, 2016-01-12]
bobhuxley/stls/pcb_spacer.stl
7.86 x 7.85 x 3.40
