thinkl33t/Mendel90/bobhuxley/stls/y_belt_clip.stl

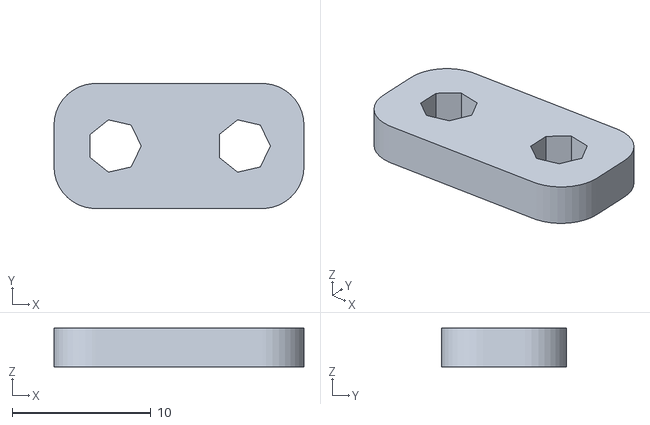
[picture p63: CAD file, 2016-01-12]
bobhuxley/stls/y_belt_clip.stl
18.0 x 9.00 x 2.80
