thinkl33t/Mendel90/bobhuxley/stls/d_shell.stl

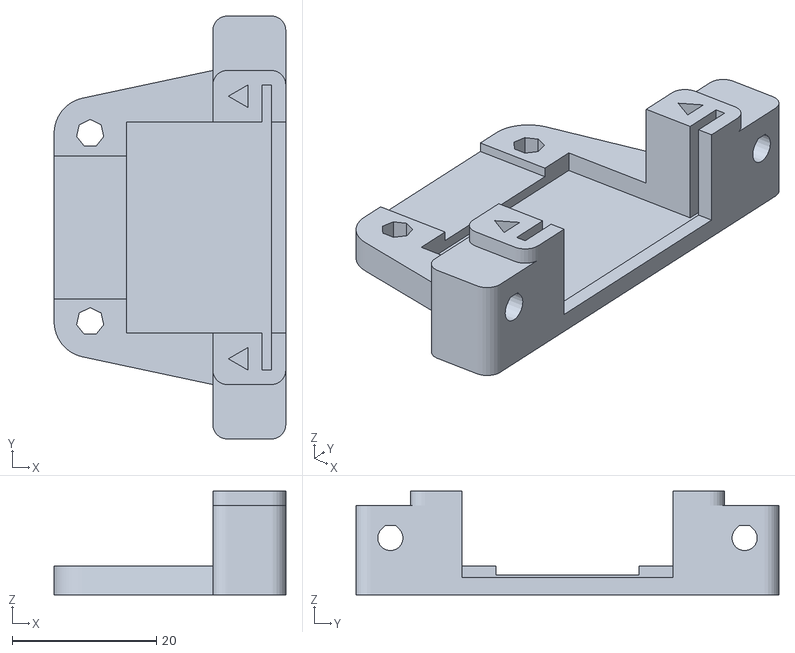
[picture p64: CAD file, 2016-01-12]
bobhuxley/stls/d_shell.stl
32.1 x 58.6 x 14.4
