thinkl33t/Mendel90/bobhuxley/stls/x_belt_clamp.stl

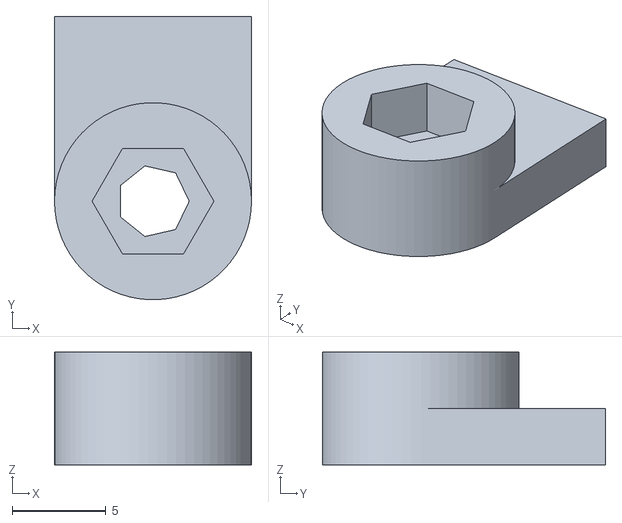
[picture p65: CAD file, 2016-01-12]
bobhuxley/stls/x_belt_clamp.stl
10.5 x 15.1 x 6.00
