thinkl33t/Mendel90/bobhuxley/stls/y_bar_clamp_switch.stl

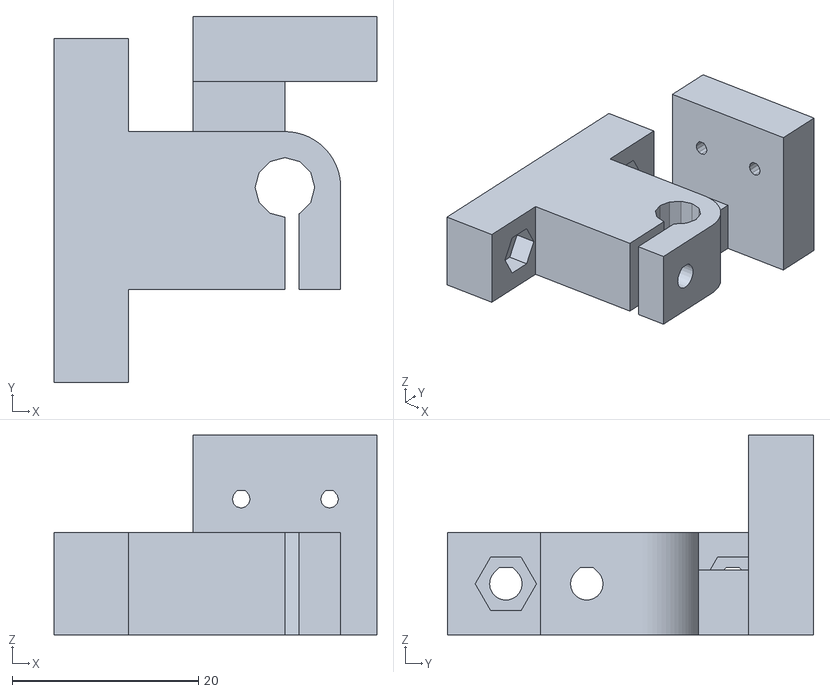
[picture p66: CAD file, 2016-01-12]
bobhuxley/stls/y_bar_clamp_switch.stl
34.7 x 39.4 x 21.5
