thinkl33t/Mendel90/scad/conf/machine.scad

include <bobhuxley_config.scad>
