thinkl33t/Mendel90/(list of files, cad)

Other CAD files:
bobhuxley/stls/z_motor_bracket_lhs.stl
bobhuxley/stls/rear_fixing_block.stl
bobhuxley/stls/y_belt_anchor.stl
bobhuxley/stls/z_screw_pointer.stl
