thinkl33t/Mendel90/bobhuxley/bom/electronics_assembly.txt

electronics_assembly:
Vitamins:
  4 M3 cap screw x 16mm
  4 Nyloc nut M3
  1 Sanguinolou electronics
  2 Heatshrink sleeving ID 2.4mm x 15mm
  8 Washer M3 x 7mm x 0.5mm

Printed:
  4 pcb_spacer.stl
