thinkl33t/Mendel90/bobhuxley/bom/extruder_assembly.txt

extruder_assembly:
Vitamins:
  1 Ball bearing 624 4mm x 13mm x 5mm
  4 M3 cap screw x 16mm
  1 M3 cap screw x 25mm
  1 M4 cap screw x 35mm
  1 M4 hex screw x 16mm
  2 M4 hex screw x 20mm
  5 Nut M3
  1 Nut M4
  1 Nyloc nut M4
  3 M3 pan screw x 8mm
  1 Spring 6.5mm OD, 0.96mm gauge x 16mm long
 10 Washer M3 x 7mm x 0.5mm
  7 Washer M4 x 9mm x 0.8mm
  8 Star washer M3 x 0.5mm

Printed:
  1 direct_block.stl
  1 direct_idler_lever.stl

Sub-assemblies:
  1 extruder_motor_assembly
  1 hot_end_assembly
