thinkl33t/Mendel90/bobhuxley/bom/extruder_motor_assembly.txt

extruder_motor_assembly:
Vitamins:
  2 M3 cap screw x 35mm
  1 M3 grub screw x 3mm
  1 hobbed pulley 8x5
  1 NEMA14 x 36mm stepper motor
  2 Nut M3
  2 No2 pan wood screw x 13mm
  2 Washer M2.5 x 5.9mm x 0.5mm
  2 Washer M3 x 7mm x 0.5mm

Printed:
  1 d_motor_bracket.stl
  1 d_motor_bracket_lid.stl

Sub-assemblies:
  1 extruder_connection_pcb_assembly
