thinkl33t/Mendel90/bobhuxley/bom/frame_assembly.txt

frame_assembly:
Vitamins:
  2 M3 cap screw x 10mm
 34 M3 cap screw x 16mm
  1 Plywood sheet 344mm x 243mm x 6mm
  1 Plywood sheet 344mm x 302mm x 6mm
  2 Plywood sheet 84mm x 302mm x 6mm
 36 Nyloc nut M3
  2 AL square tube 12.7 x 12.7 x 1.63 x 224mm
 36 Washer M3 x 7mm x 0.5mm
 10 Ziptie 100mm min length

Printed:
  8 fixing_block.stl
  2 rear_fixing_block.stl
  1 ribbon_clamp_20_33N.stl
  1 ribbon_clamp_26_33N.stl
  4 tube_cap.stl
