thinkl33t/Mendel90/bobhuxley/bom/machine_assembly.txt

machine_assembly:
Vitamins:

Printed:

Sub-assemblies:
  1 bed_fan_assembly
  1 electronics_assembly
  1 frame_assembly
  1 psu_assembly
  1 raspberry_pi_camera_assembly
  1 spool_holder_assembly
  1 x_axis_assembly
  1 y_axis_assembly
  1 z_axis_assembly
