thinkl33t/Mendel90/bobhuxley/bom/raspberry_pi_camera_assembly.txt

raspberry_pi_camera_assembly:
Vitamins:
  3 M2 cap screw x 12mm
  2 M3 cap screw x 16mm
  4 M3 hex screw x 16mm
  3 Nyloc nut M2
  6 Nyloc nut M3
  1 Rigid 5050 light strip x 208mm
  1 Raspberry PI camera
  3 Washer M2 x 5mm x 0.3mm
  6 Washer M3 x 7mm x 0.5mm

Printed:
  1 light_and_camera_brackets.stl
  1 rear_light_brackets.stl
  1 rpi_camera_back.stl
  1 rpi_camera_case.stl
