thinkl33t/Mendel90/bobhuxley/bom/x_axis_assembly.txt

x_axis_assembly:
Vitamins:
  1 Belt T2 x 6mm x 666mm
  2 Smooth rod 6mm x 275mm
  2 Wingnut M4

Printed:

Sub-assemblies:
  1 extruder_assembly
  1 x_carriage_assembly
  1 x_carriage_fan_assembly
