thinkl33t/Mendel90/bobhuxley/bom/x_carriage_assembly.txt

x_carriage_assembly:
Vitamins:
  2 M3 cap screw x 16mm
  1 M3 cap screw x 20mm
  2 M3 cap screw x 25mm
  3 LM6UU linear bearing
  1 Nut M3
  4 Nyloc nut M3
  4 Washer M3 x 7mm x 0.5mm
  3 Ziptie 100mm min length

Printed:
  1 x_belt_clamp.stl
  1 x_belt_grip.stl
  1 x_belt_tensioner.stl
  1 x_carriage.stl
