thinkl33t/Mendel90/bobhuxley/bom/x_carriage_fan_assembly.txt

x_carriage_fan_assembly:
Vitamins:
  4 M3 cap screw x 25mm
  1 Fan 40mm x 11mm
  4 Nyloc nut M3
  4 Washer M3 x 7mm x 0.5mm

Printed:
  1 x_carriage_fan_bracket.stl
  1 x_carriage_fan_duct.stl
