thinkl33t/Mendel90/bobhuxley/bom/y_axis_assembly.txt

y_axis_assembly:
Vitamins:
  1 Belt T2 x 6mm x 432mm
 12 M3 cap screw x 16mm
 12 Nyloc nut M3
  2 No2 pan wood screw x 13mm
  1 Smooth rod 6mm x 199mm
  1 Smooth rod 6mm x 241mm
  1 Microswitch
  2 Washer M2.5 x 5.9mm x 0.5mm
 12 Washer M3 x 7mm x 0.5mm

Printed:
  3 y_bar_clamp.stl
  1 y_bar_clamp_switch.stl

Sub-assemblies:
  1 print_bed_assembly
  1 y_idler_assembly
  1 y_motor_assembly
