thinkl33t/Mendel90/bobhuxley/bom/y_carriage_assembly.txt

y_carriage_assembly:
Vitamins:
 14 M3 cap screw x 16mm
  2 M3 cap screw x 20mm
  3 LM6UU linear bearing
  1 Plywood sheet 166mm x 100mm x 6mm
 16 Nyloc nut M3
 16 Washer M3 x 7mm x 0.5mm
  3 Ziptie 100mm min length

Printed:
  1 ribbon_clamp_26_33.stl
  1 ribbon_clamp_26_33N.stl
  3 y_bearing_mount.stl
  1 y_belt_anchor.stl
  1 y_belt_anchor_toothed.stl
  1 y_belt_clip.stl
  1 y_belt_clip_toothed.stl
