thinkl33t/Mendel90/bobhuxley/bom/y_motor_assembly.txt

y_motor_assembly:
Vitamins:
  4 M3 cap screw x 16mm
  2 M3 grub screw x 6mm
  1 NEMA14 x 36mm stepper motor
  4 Nyloc nut M3
  4 M3 pan screw x 8mm
  1 GT2 pulley 20 teeth
  8 Washer M3 x 7mm x 0.5mm
  4 Star washer M3 x 0.5mm

Printed:
  1 y_motor_bracket.stl
