thinkl33t/Mendel90/bobhuxley/bom/z_axis_assembly.txt

z_axis_assembly:
Vitamins:
  6 M3 cap screw x 16mm
  2 Brass nut M5
  6 Nyloc nut M3
  2 No2 pan wood screw x 13mm
  2 Smooth rod 6mm x 265mm
  1 Microswitch
  2 Threaded rod M5 x 229mm
  2 Washer M2.5 x 5.9mm x 0.5mm
  6 Washer M3 x 7mm x 0.5mm

Printed:
  2 z_bar_clamp.stl
  2 z_screw_pointer.stl

Sub-assemblies:
  1 x_idler_assembly
  1 x_motor_assembly
  2 z_motor_assemblies
