thinkl33t/Mendel90/bobhuxley/bom/z_motor_assembly.txt

z_motor_assemblies:
Vitamins:
 14 M3 cap screw x 16mm
  2 NEMA14 x 36mm stepper motor
 14 Nyloc nut M3
  8 M3 pan screw x 8mm
  2 Neoprene tubing OD 8mm ID 5mm x 15mm
 22 Washer M3 x 7mm x 0.5mm
  8 Star washer M3 x 0.5mm

Printed:
  4 z_coupling.stl
  1 z_motor_bracket_lhs.stl
  1 z_motor_bracket_rhs.stl
