thinkl33t/Mendel90/bobhuxley/sheets/frame_base.pdf

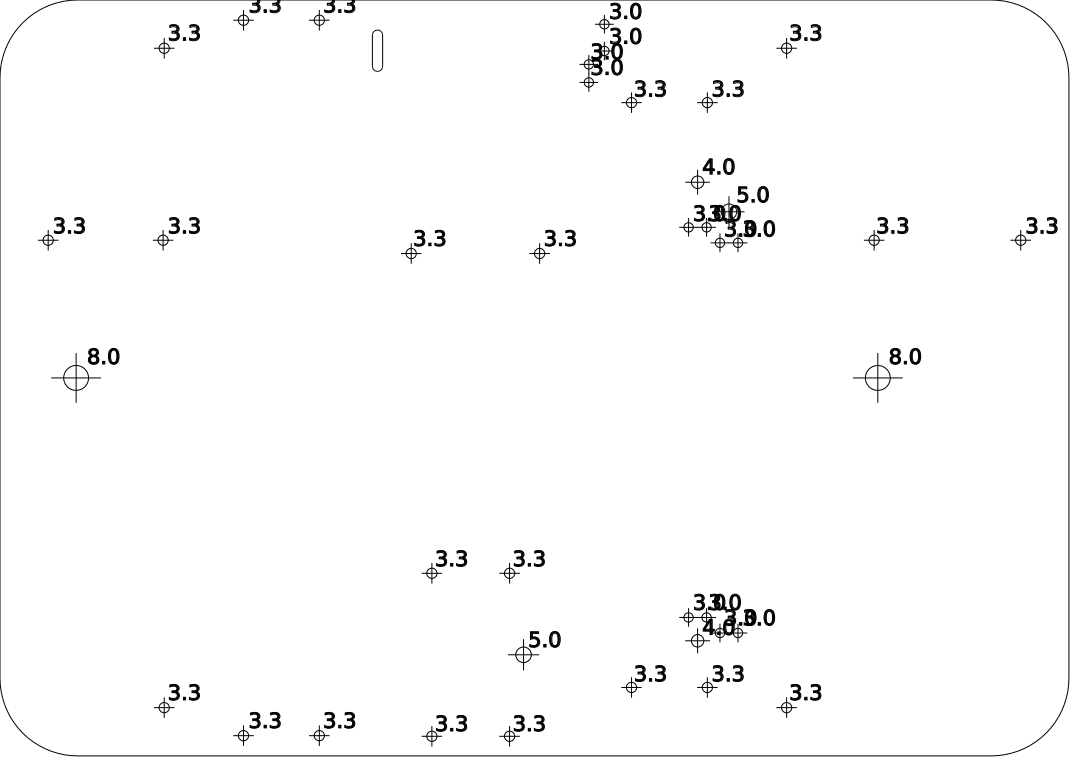
[picture p67: page 1]
