thinkl33t/Mendel90/bobhuxley/sheets/frame_gantry.pdf

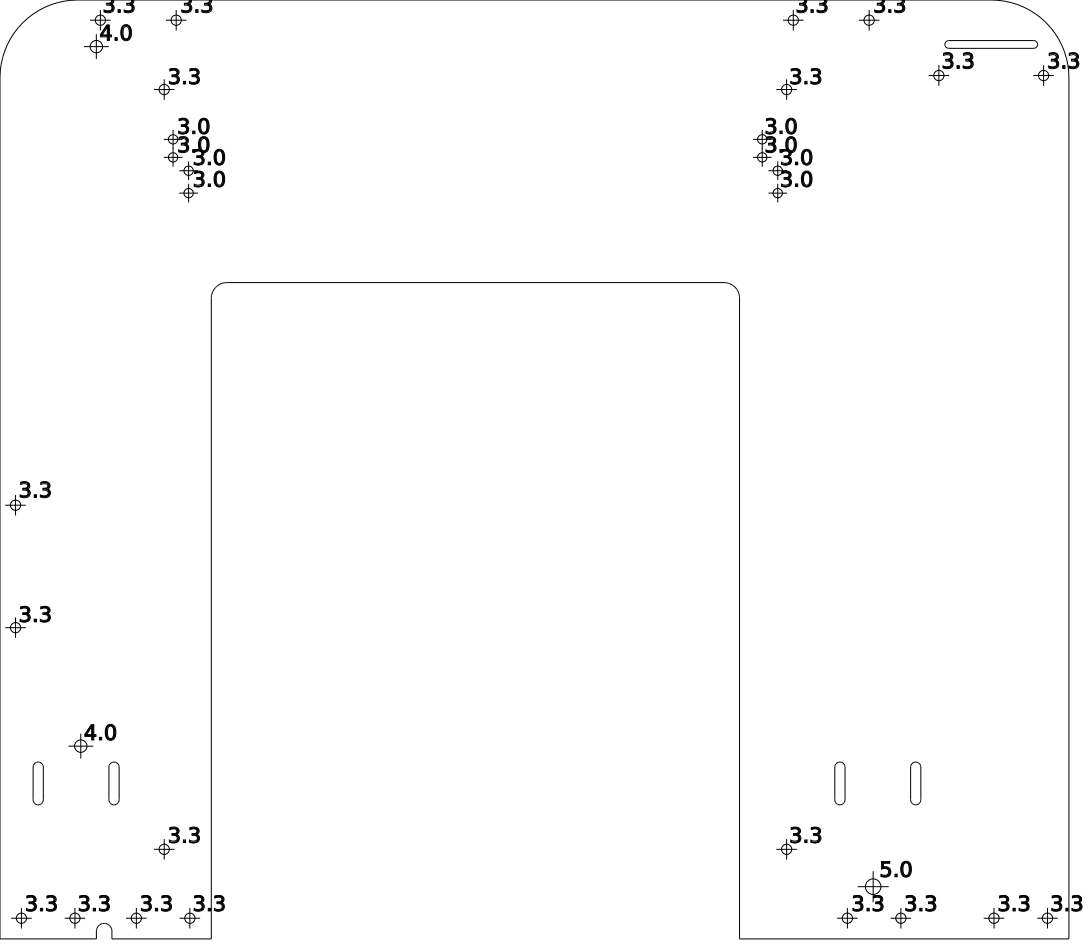
[picture p68: page 1]
