thinkl33t/Mendel90/bobhuxley/sheets/frame_gantry_and_y_carriage.pdf

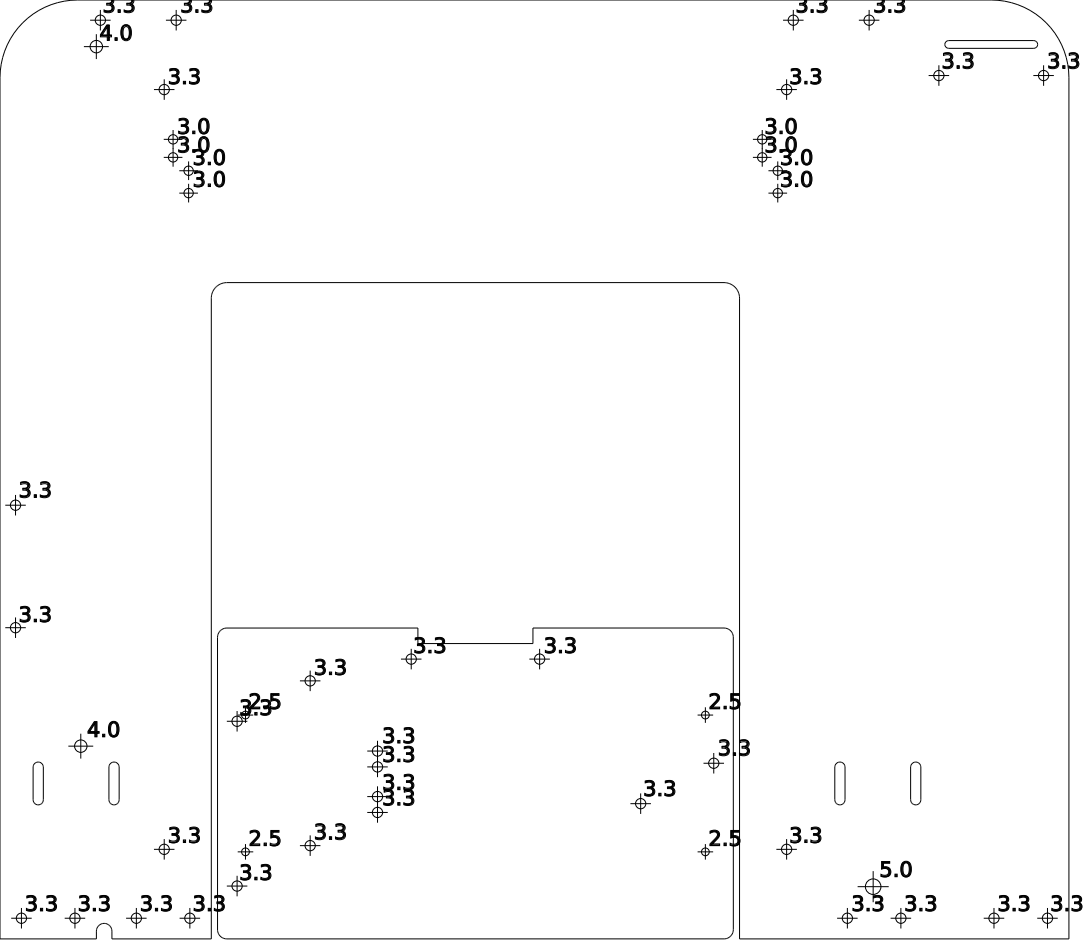
[picture p69: page 1]
