thinkl33t/Mendel90/bobhuxley/sheets/frame_left.pdf

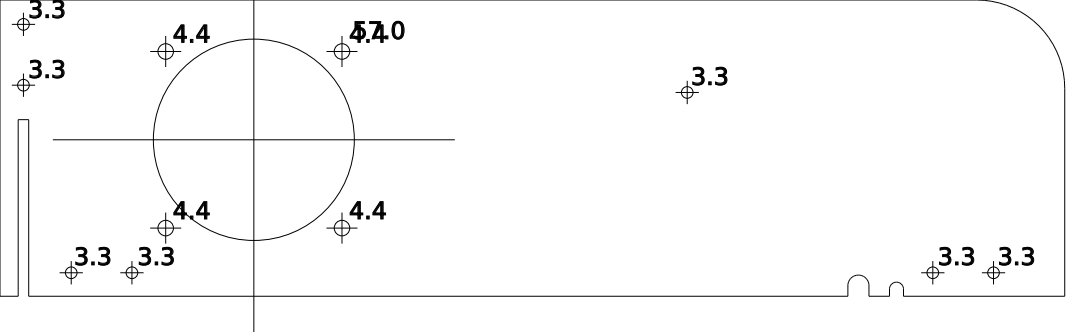
[picture p70: page 1]
