thinkl33t/Mendel90/bobhuxley/sheets/frame_right.pdf

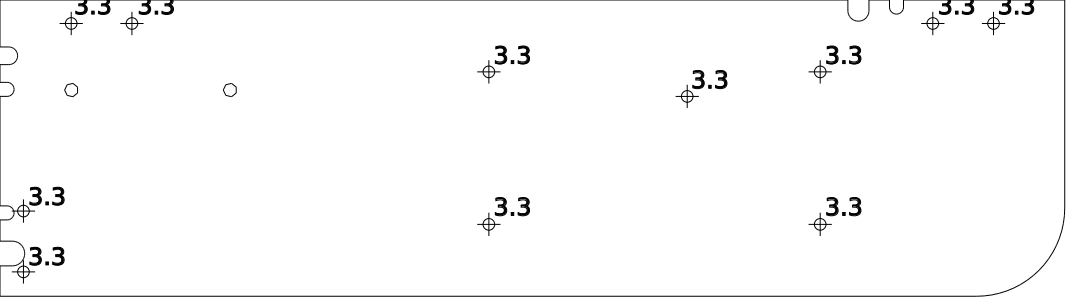
[picture p71: page 1]
