thinkl33t/Mendel90/bobhuxley/sheets/frame_stays.pdf

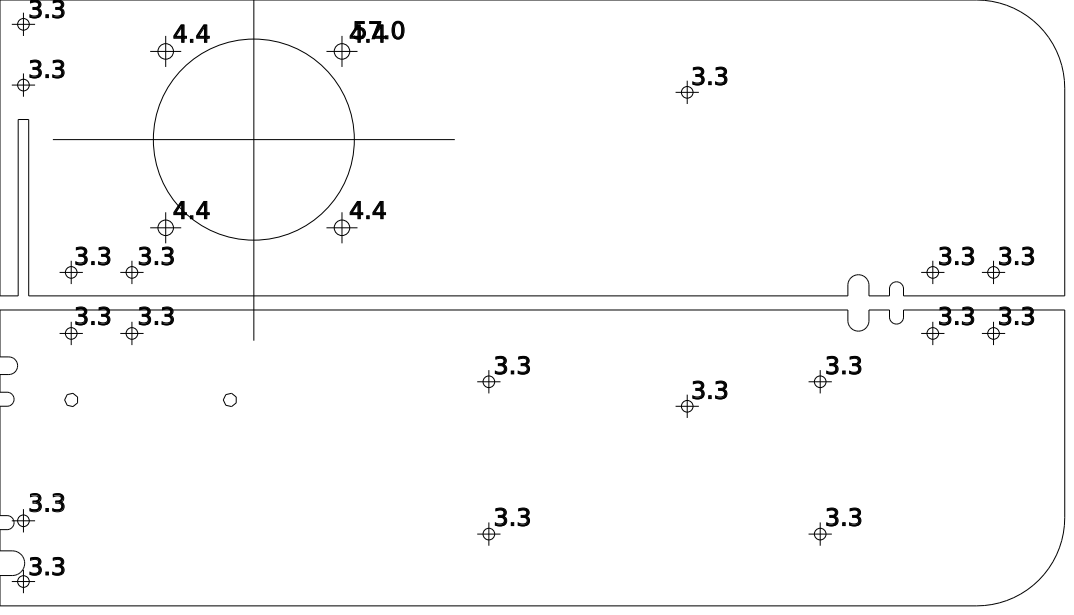
[picture p72: page 1]
