thinkl33t/Mendel90/bobhuxley/sheets/y_carriage.pdf

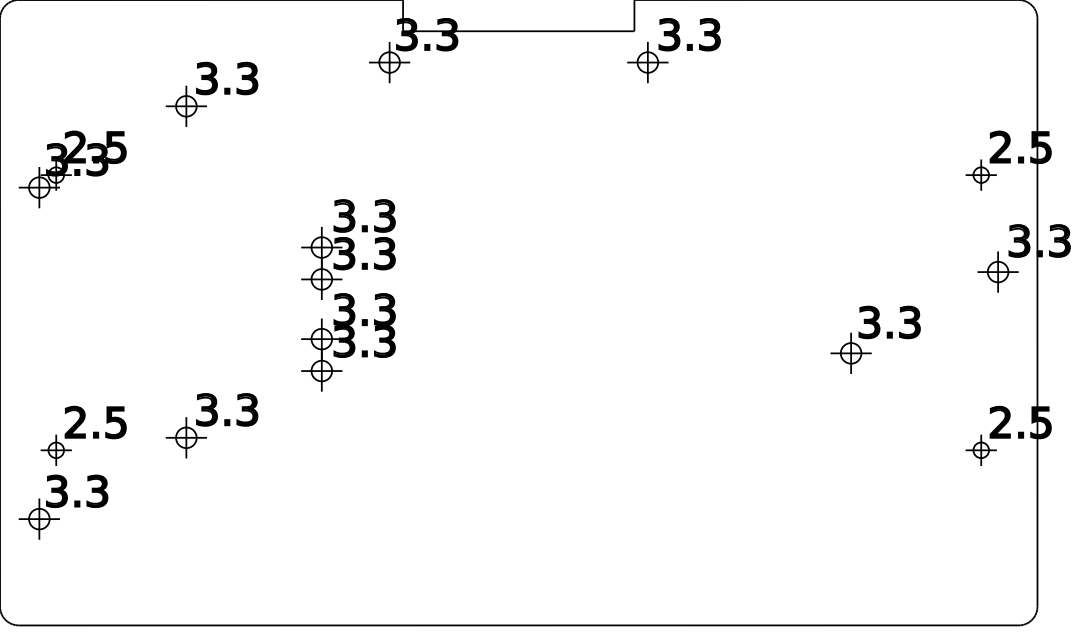
[picture p73: page 1]
