thinkl33t/Mendel90/(commit log)

2016-01-12 Added extra bits for my huxley- using RRPro heated bed, and 6mm laser cut plywood
    [bed.scad, bobhuxley_config.scad, machine.scad, pillars.scad, sheet.scad]
2016-01-12 Added output files for my huxley
    [atx_brackets.stl, bar_clamps.stl, cable_clips.stl, cal.stl, d_motor_bracket.stl, d_motor_bracket_lid.stl, d_motor_brackets.stl, d_shell.stl]
